JonahZil/fpga-radar-projects/8-point-SDF/README.md

A small proof of concept for a SDF FFT. Includes three stage modules for the 8 point scaled FFT, where each stage module is fully scalable and works for larger FFTs. 

A small testbench is included for the function cos(2pi*n/16), with the console output correctly showing two high output bins while the rest are 0.
