JonahZil/fpga-radar-projects/nonlinearity-tests/python-files/fft-graphs/new/experiment 3/100/3_difference_spectra.png

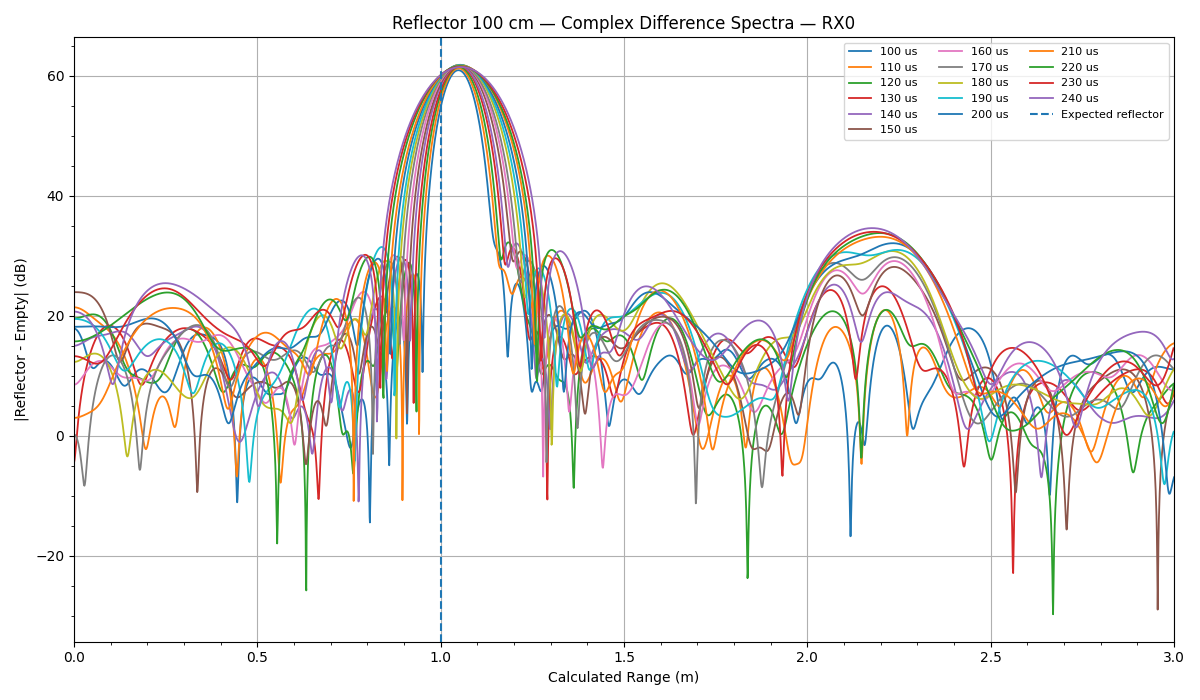
nonlinearity-tests/python-files/fft-graphs/new/experiment 3/100/3_difference_spectra.png
