JonahZil/fpga-radar-projects/nonlinearity-tests/python-files/fft-graphs/new/complex-average/complex-averaging-50.png

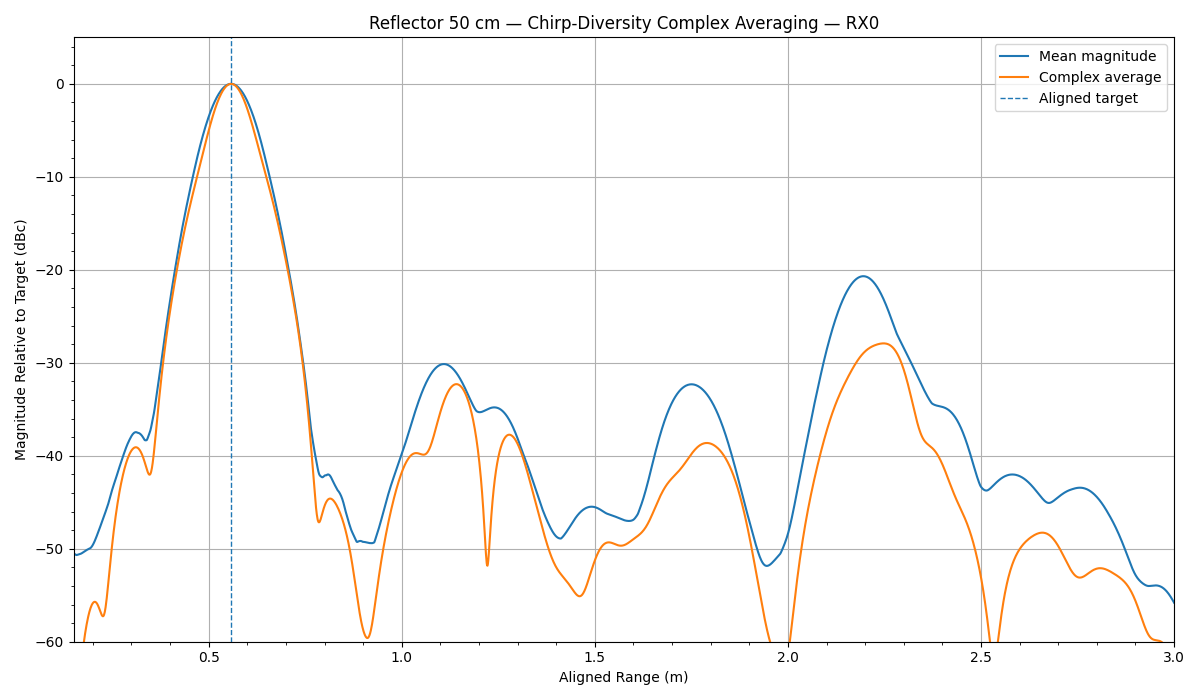
nonlinearity-tests/python-files/fft-graphs/new/complex-average/complex-averaging-50.png
