JonahZil/fpga-radar-projects/nonlinearity-tests/python-files/fft-graphs/new/complex-average/complex_averaging_phase_50.png

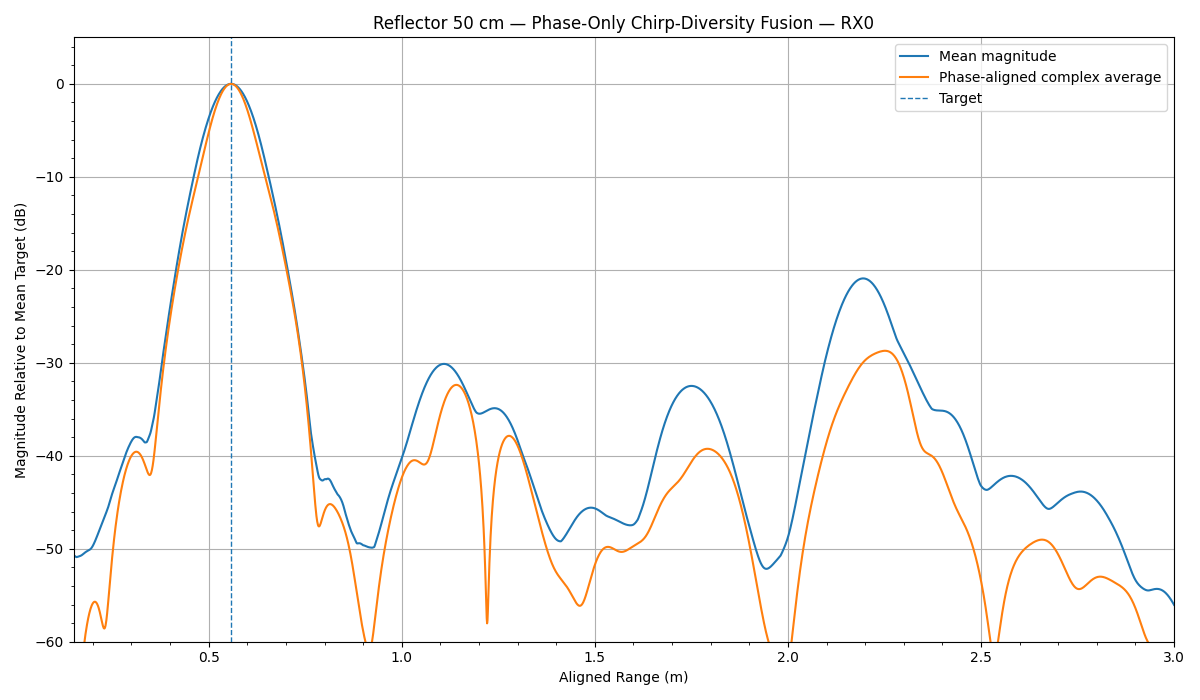
nonlinearity-tests/python-files/fft-graphs/new/complex-average/complex_averaging_phase_50.png
