JonahZil/fpga-radar-projects/nonlinearity-tests/python-files/fft-graphs/new/complex-average/ground_truth.png

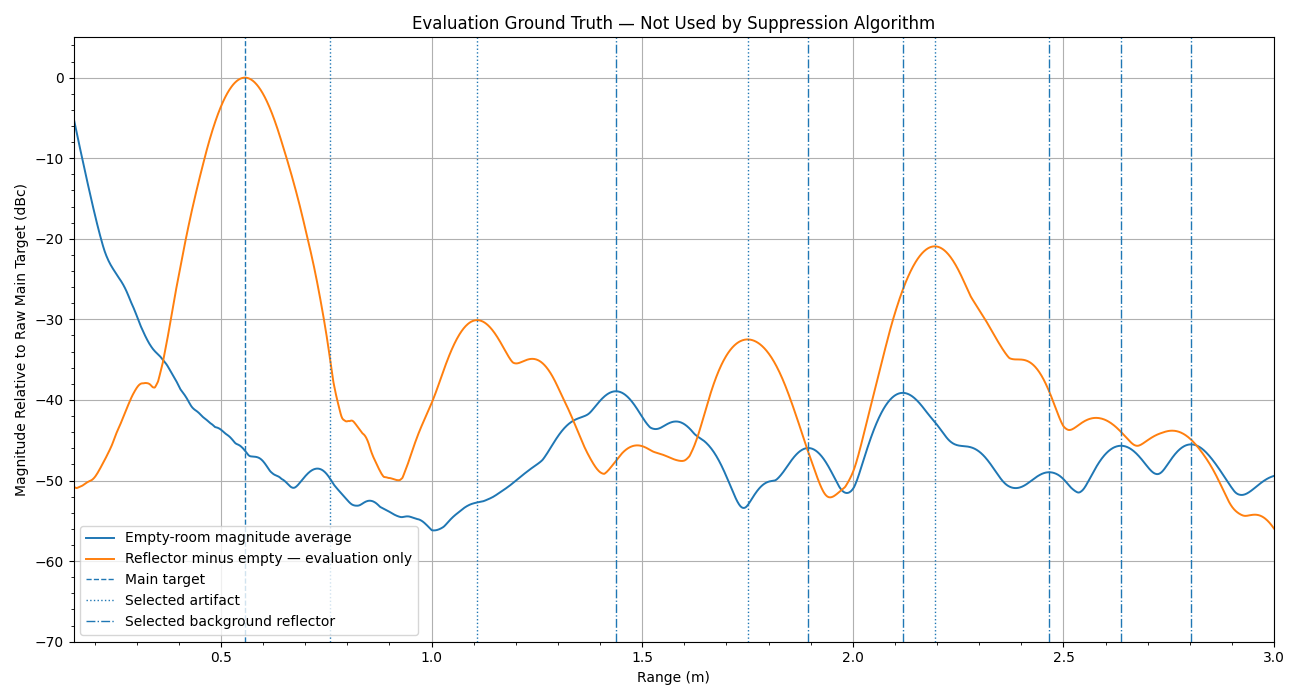
nonlinearity-tests/python-files/fft-graphs/new/complex-average/ground_truth.png
