JonahZil/fpga-radar-projects/nonlinearity-tests/python-files/fft-graphs/new/complex-average/harmonic_phase.png

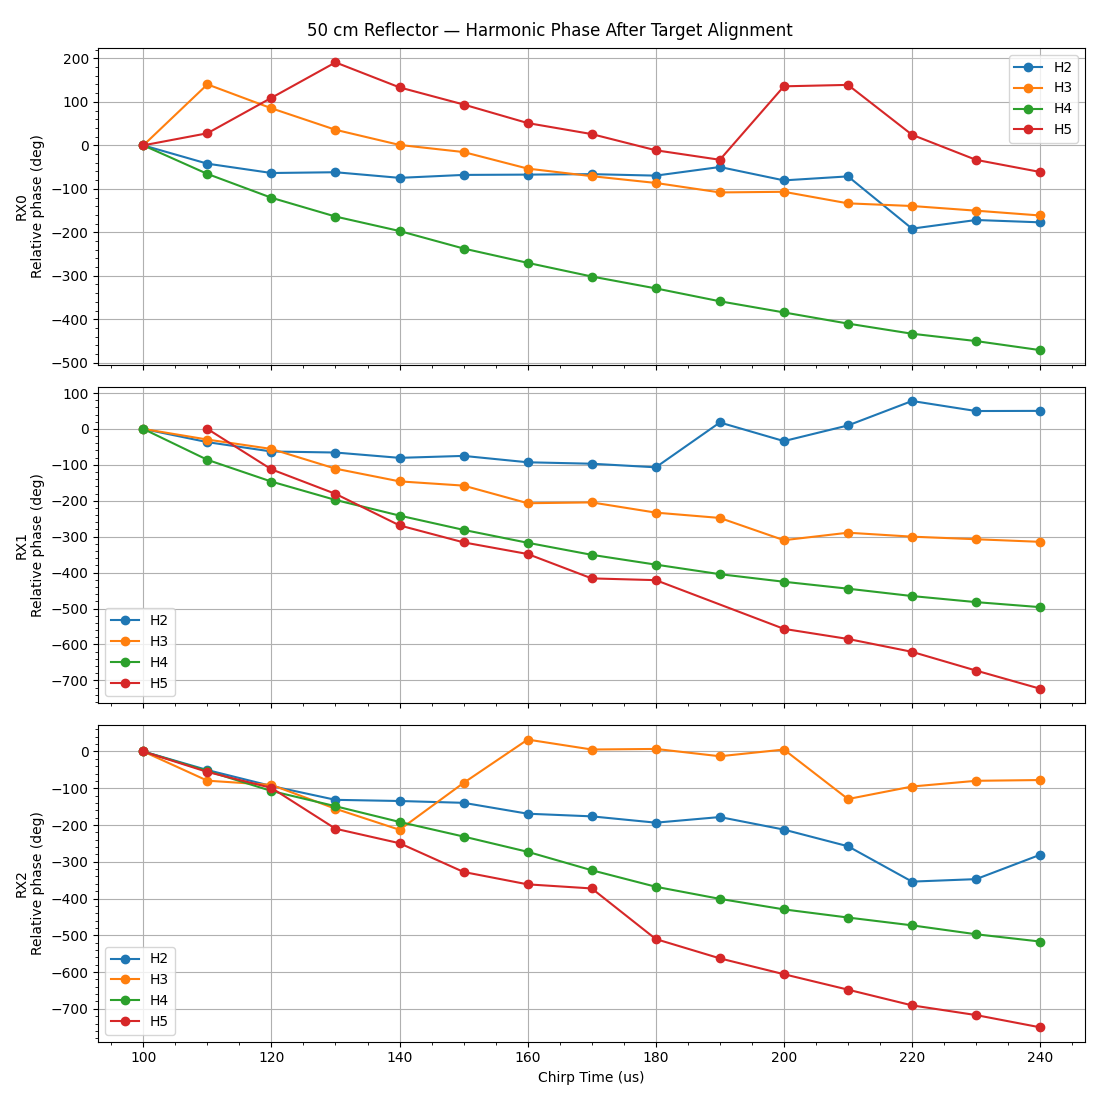
nonlinearity-tests/python-files/fft-graphs/new/complex-average/harmonic_phase.png
