JonahZil/fpga-radar-projects/nonlinearity-tests/python-files/fft-graphs/new/complex-average/linear_fits.png

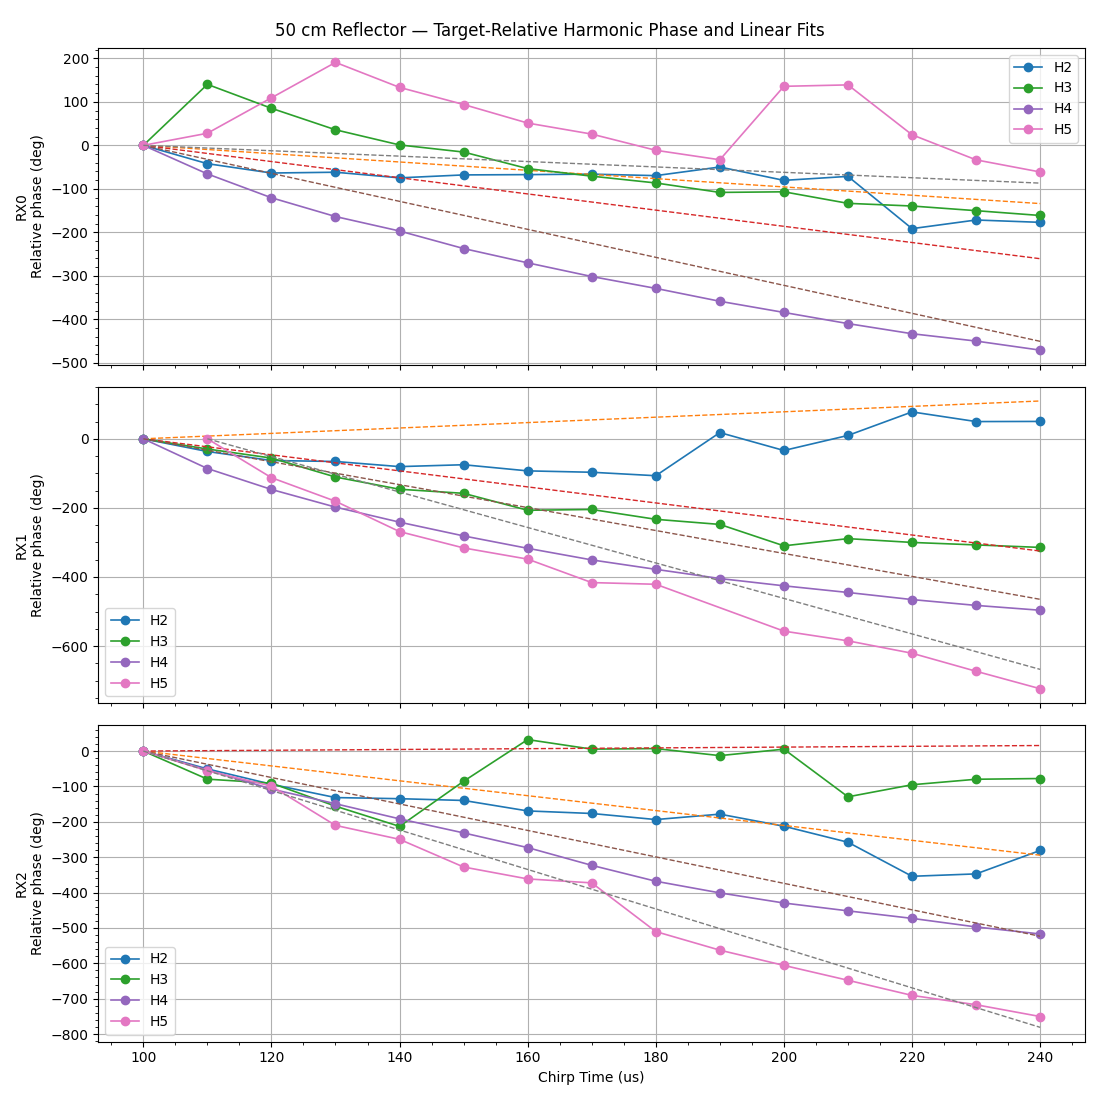
nonlinearity-tests/python-files/fft-graphs/new/complex-average/linear_fits.png
