JonahZil/fpga-radar-projects/nonlinearity-tests/python-files/fft-graphs/new/complex-average/no_background_fusion.png

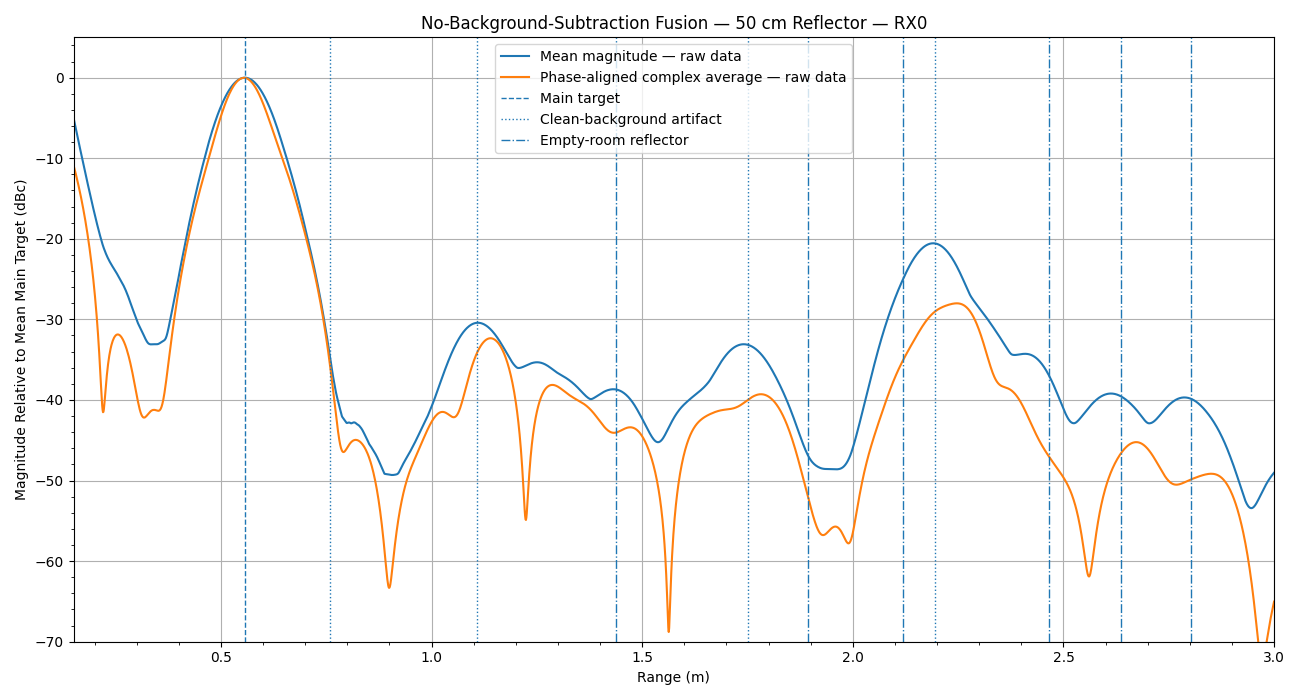
nonlinearity-tests/python-files/fft-graphs/new/complex-average/no_background_fusion.png
