JonahZil/fpga-radar-projects/nonlinearity-tests/python-files/fft-graphs/new/complex-average/phase_offset.png

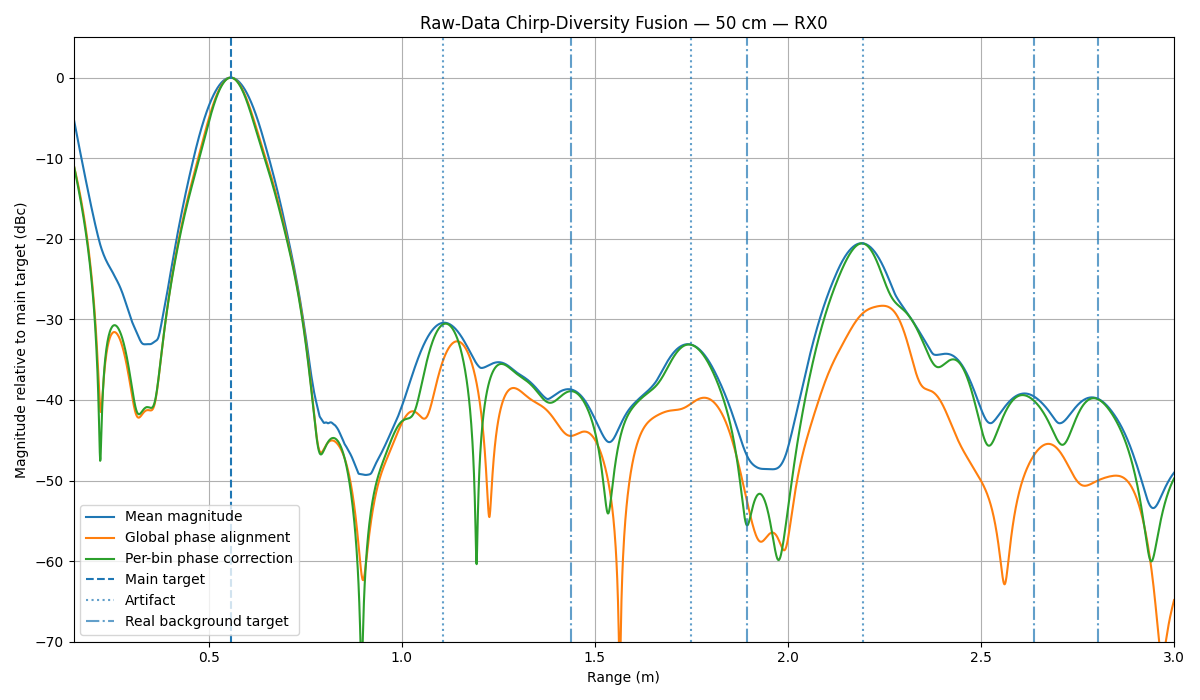
nonlinearity-tests/python-files/fft-graphs/new/complex-average/phase_offset.png
