JonahZil/fpga-radar-projects/nonlinearity-tests/python-files/fft-graphs/new/complex-average/suppression_vs_chirpdiv.png

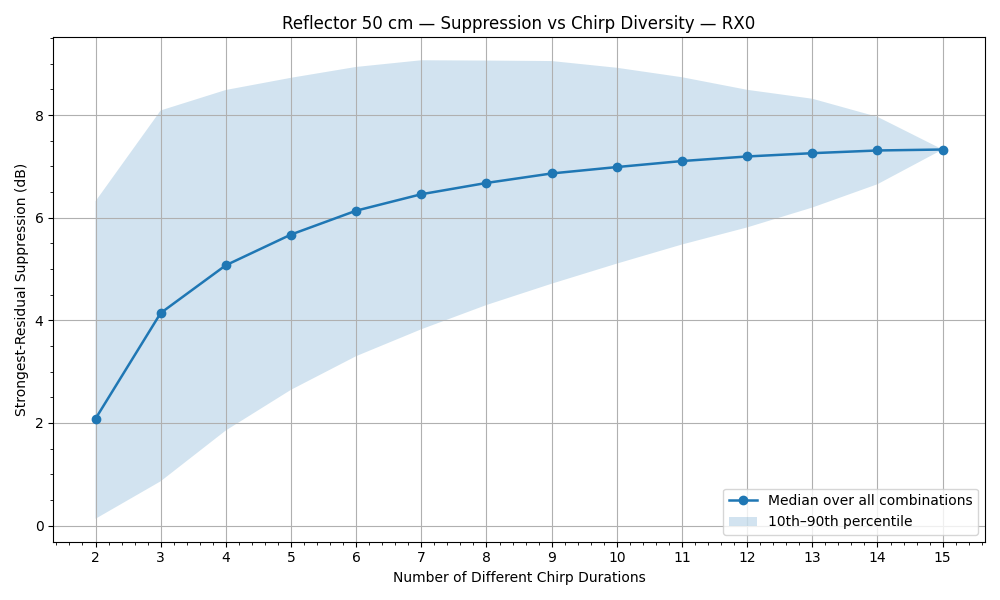
nonlinearity-tests/python-files/fft-graphs/new/complex-average/suppression_vs_chirpdiv.png
