JonahZil/fpga-radar-projects/nonlinearity-tests/python-files/fft-graphs/new/complex-average/supression_at_range.png

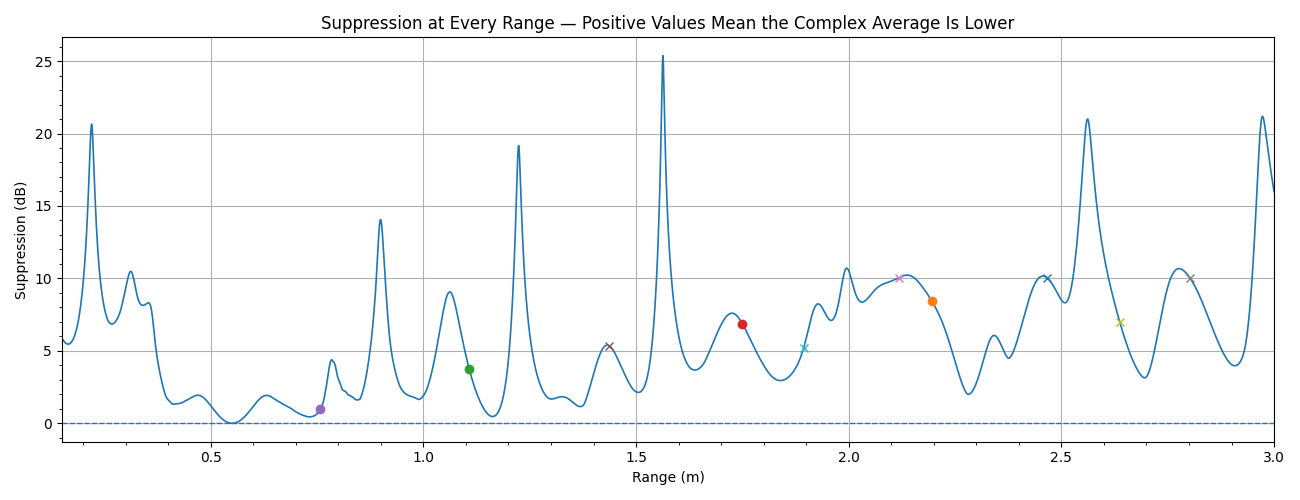
nonlinearity-tests/python-files/fft-graphs/new/complex-average/supression_at_range.png
