JonahZil/fpga-radar-projects/nonlinearity-tests/python-files/fft-graphs/new/experiment 1/1_15_mean.png

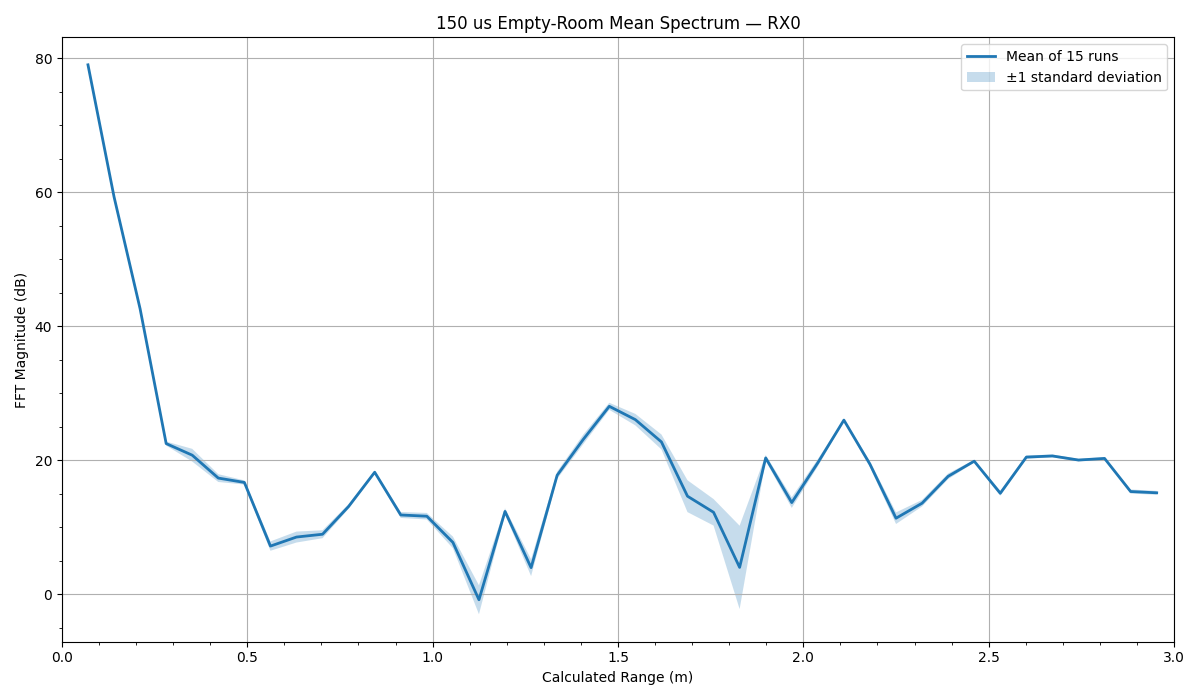
nonlinearity-tests/python-files/fft-graphs/new/experiment 1/1_15_mean.png
