JonahZil/fpga-radar-projects/nonlinearity-tests/python-files/fft-graphs/new/experiment 1/1_15_overlay.png

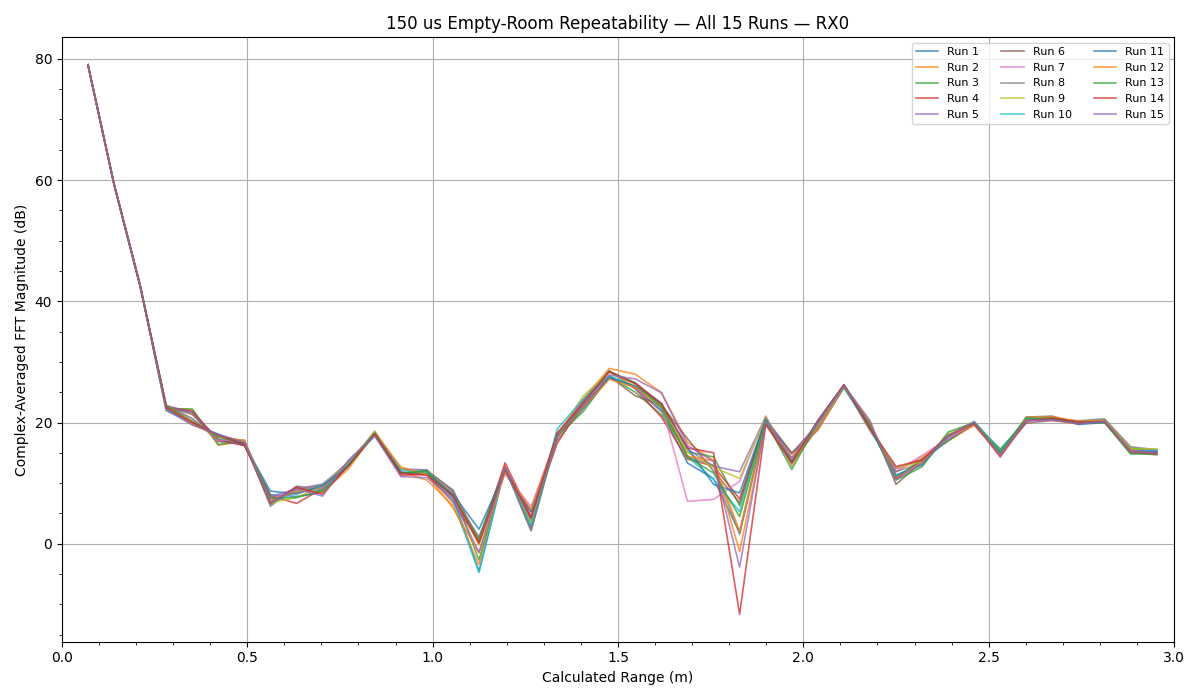
nonlinearity-tests/python-files/fft-graphs/new/experiment 1/1_15_overlay.png
