JonahZil/fpga-radar-projects/nonlinearity-tests/python-files/fft-graphs/new/experiment 2/2_diff_heat.png

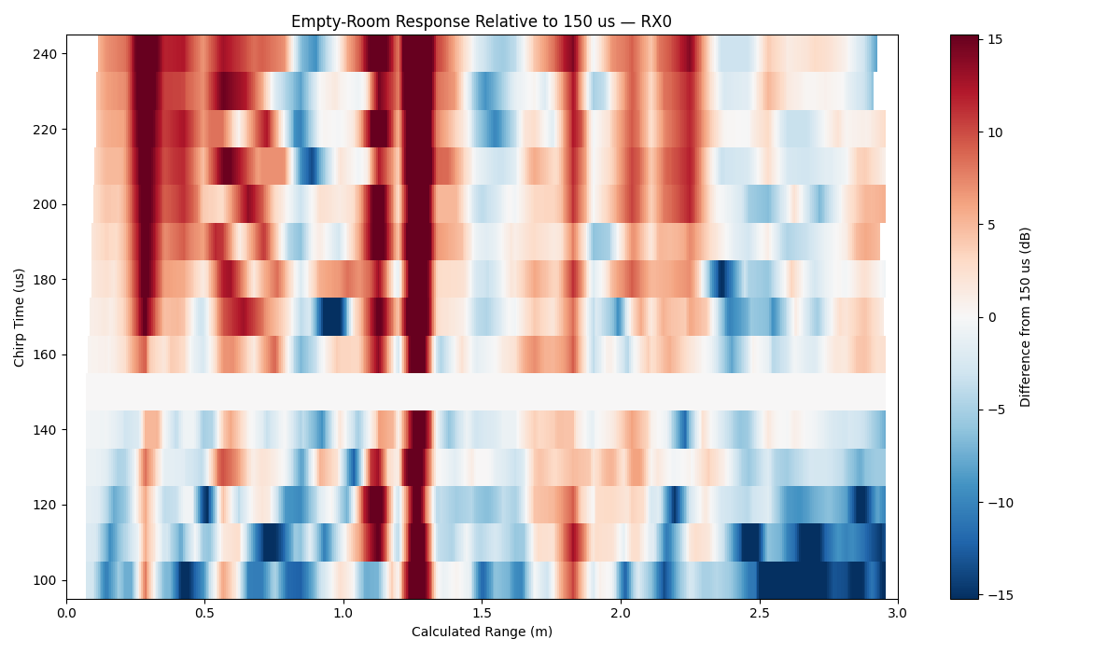
nonlinearity-tests/python-files/fft-graphs/new/experiment 2/2_diff_heat.png
