JonahZil/fpga-radar-projects/nonlinearity-tests/python-files/fft-graphs/new/experiment 2/2_empty_sweep_range.png

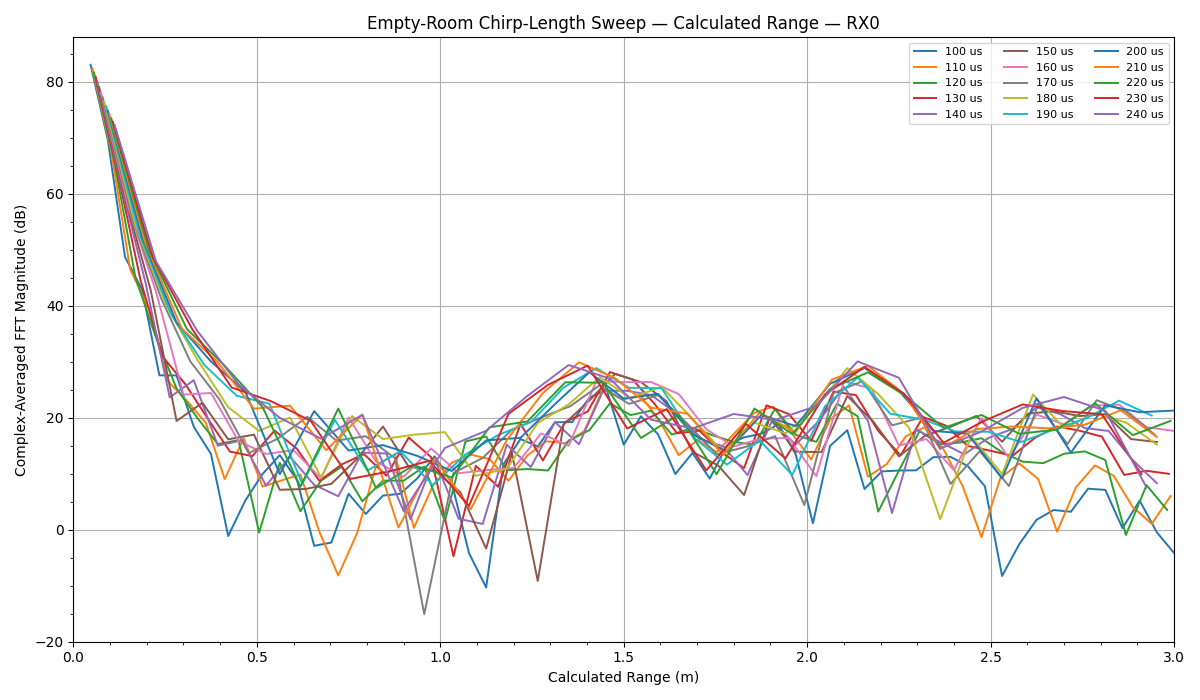
nonlinearity-tests/python-files/fft-graphs/new/experiment 2/2_empty_sweep_range.png
