JonahZil/fpga-radar-projects/nonlinearity-tests/python-files/fft-graphs/new/experiment 2/2exp_beatfreq_vs_time.png

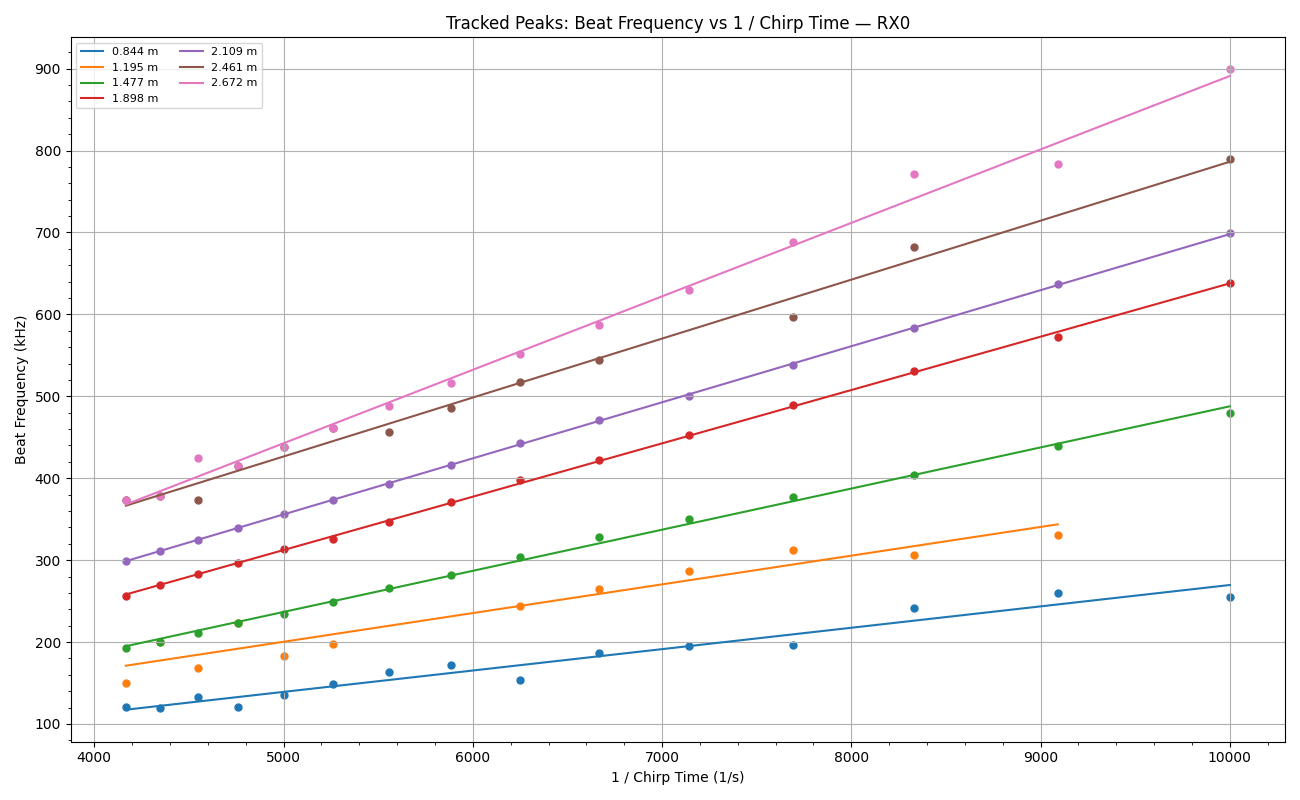
nonlinearity-tests/python-files/fft-graphs/new/experiment 2/2exp_beatfreq_vs_time.png
