JonahZil/fpga-radar-projects/nonlinearity-tests/python-files/fft-graphs/new/experiment 3/50/3_diff_relative_target.png

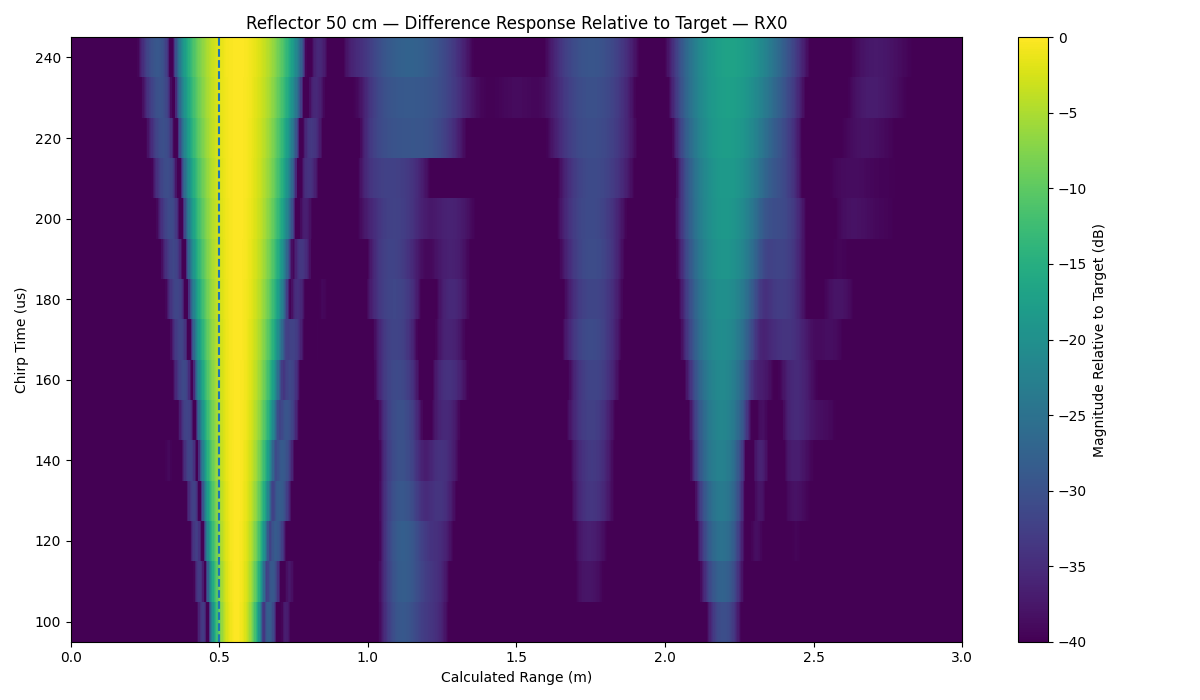
nonlinearity-tests/python-files/fft-graphs/new/experiment 3/50/3_diff_relative_target.png
