JonahZil/fpga-radar-projects/nonlinearity-tests/python-files/fft-graphs/new/experiment 3/50/3_difference_beatfreq_heat.png

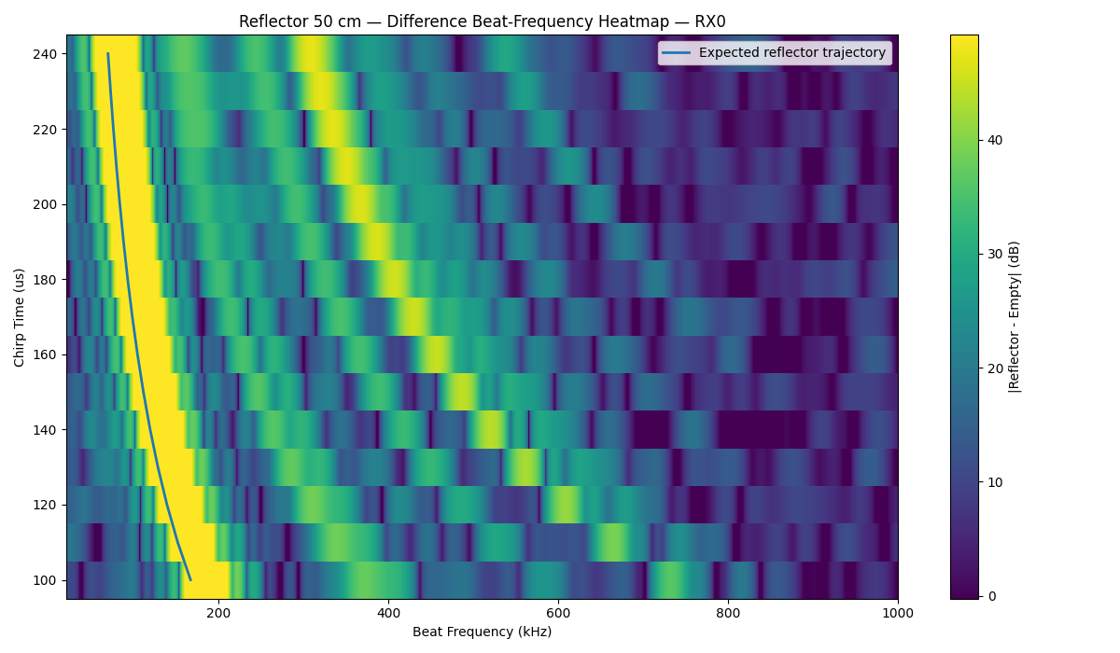
nonlinearity-tests/python-files/fft-graphs/new/experiment 3/50/3_difference_beatfreq_heat.png
