JonahZil/fpga-radar-projects/nonlinearity-tests/python-files/fft-graphs/new/experiment 3/50/3_difference_peak_mag.png

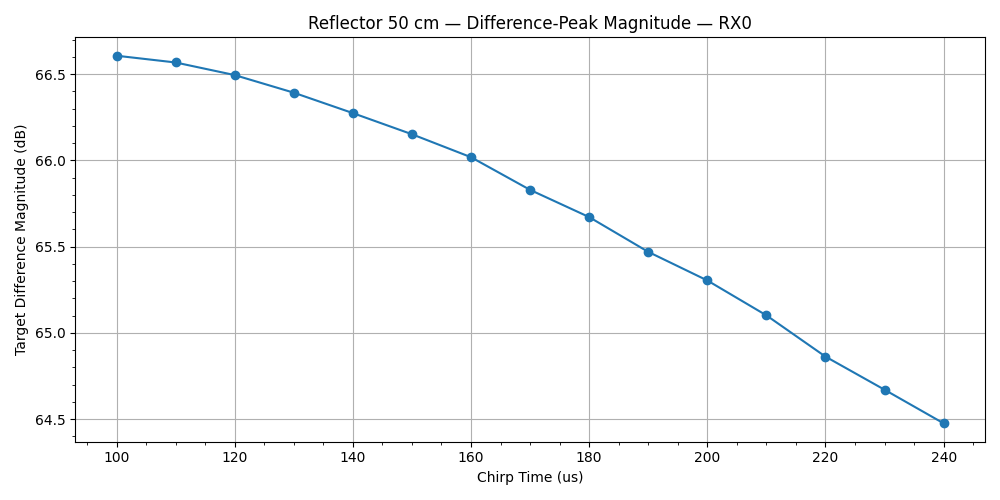
nonlinearity-tests/python-files/fft-graphs/new/experiment 3/50/3_difference_peak_mag.png
