JonahZil/fpga-radar-projects/nonlinearity-tests/python-files/fft-graphs/new/experiment 3/100/3_diff_relative_target.png

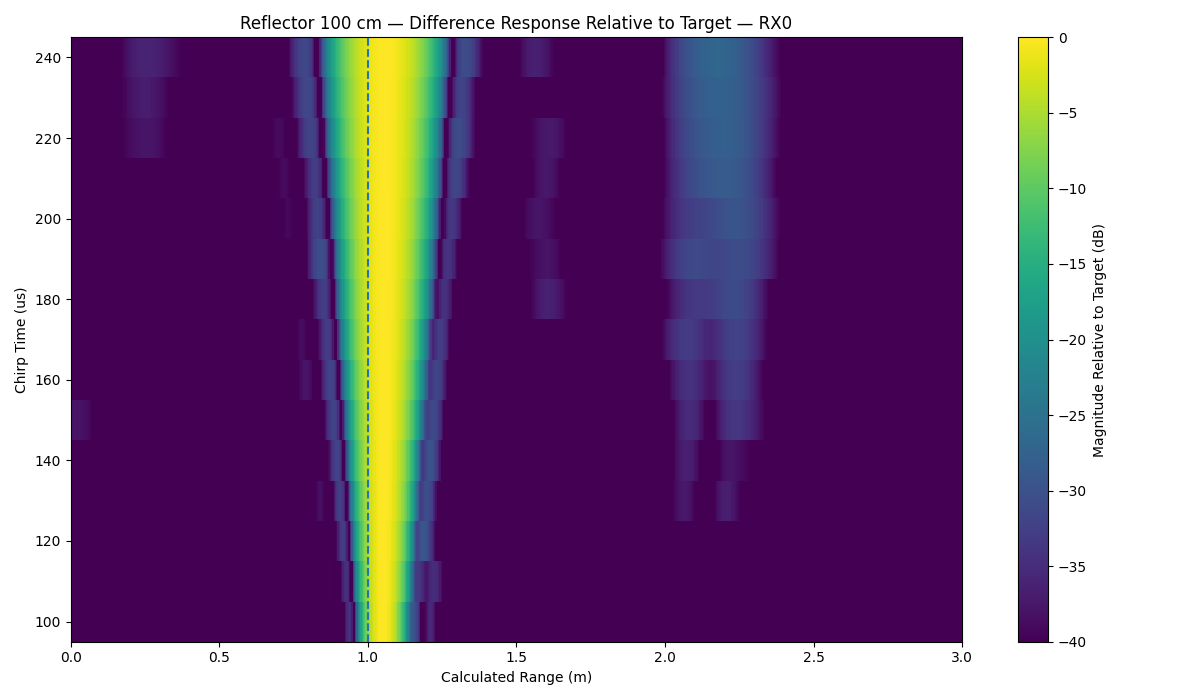
nonlinearity-tests/python-files/fft-graphs/new/experiment 3/100/3_diff_relative_target.png
