JonahZil/fpga-radar-projects/nonlinearity-tests/python-files/fft-graphs/new/experiment 3/150/3_difference_beatfreq_heat.png

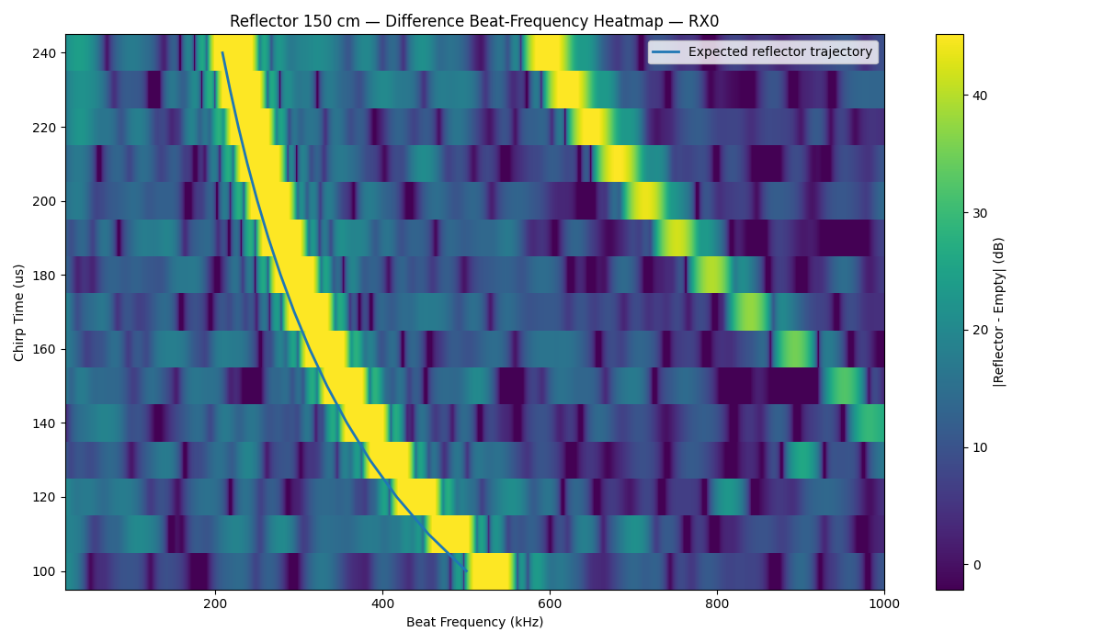
nonlinearity-tests/python-files/fft-graphs/new/experiment 3/150/3_difference_beatfreq_heat.png
