JonahZil/fpga-radar-projects/nonlinearity-tests/python-files/fft-graphs/new/experiment 3/tracked_difference_peak.png

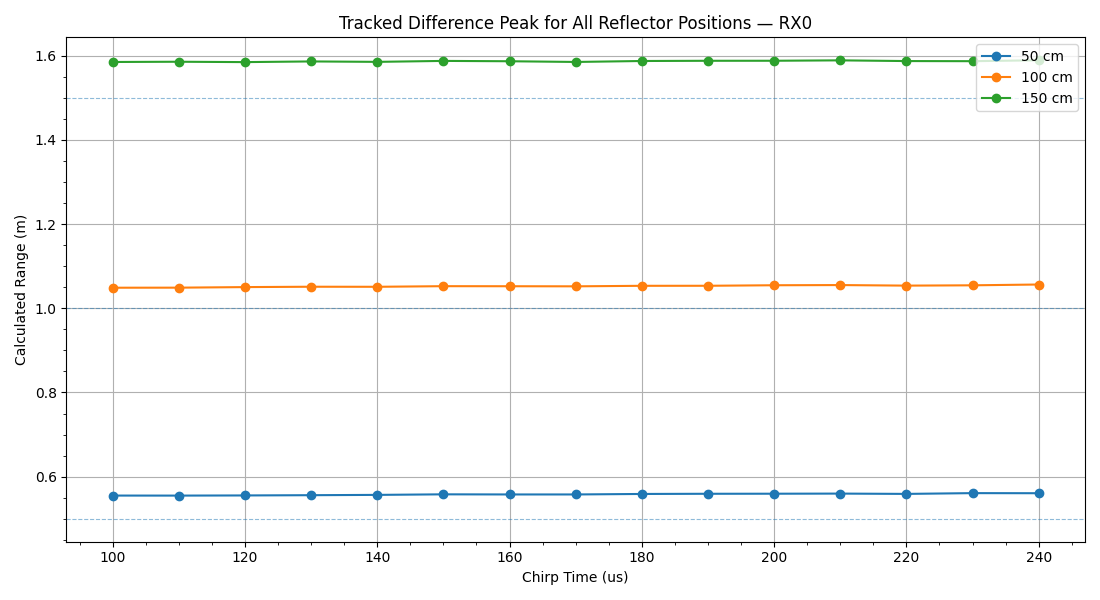
nonlinearity-tests/python-files/fft-graphs/new/experiment 3/tracked_difference_peak.png
