JonahZil/fpga-radar-projects/nonlinearity-tests/python-files/fft-graphs/new/multiple_freq/50_harmonic_freq.png

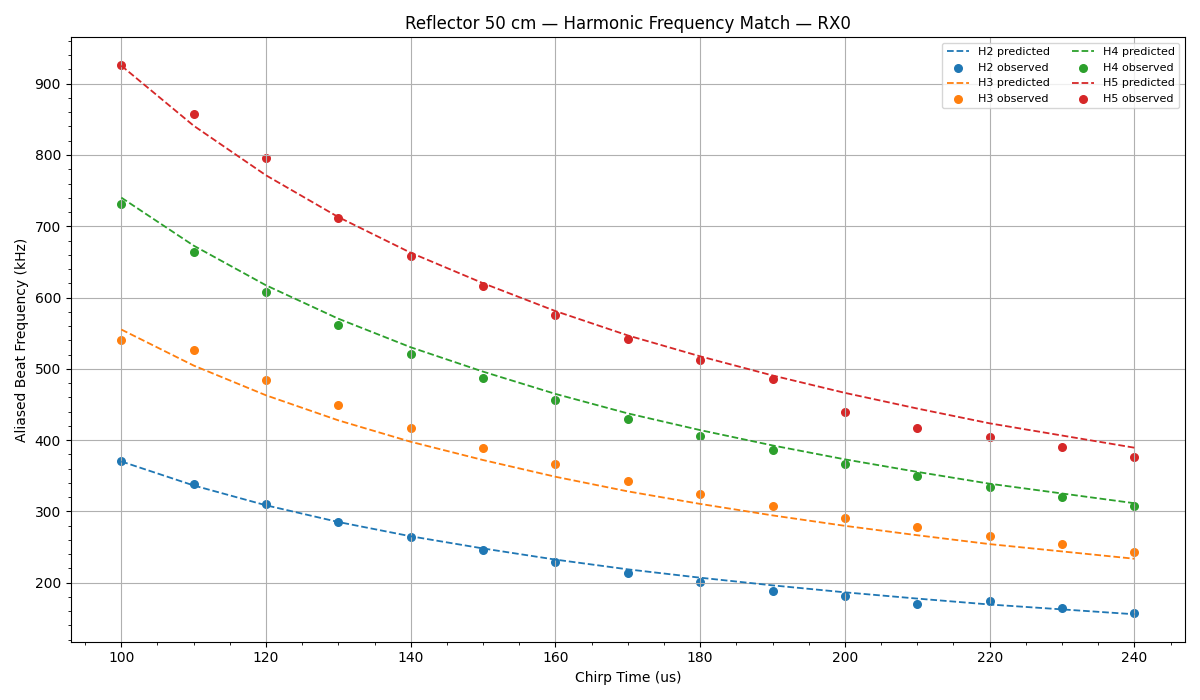
nonlinearity-tests/python-files/fft-graphs/new/multiple_freq/50_harmonic_freq.png
