JonahZil/fpga-radar-projects/nonlinearity-tests/python-files/fft-graphs/new/multiple_freq/150_harmonic_freq.png

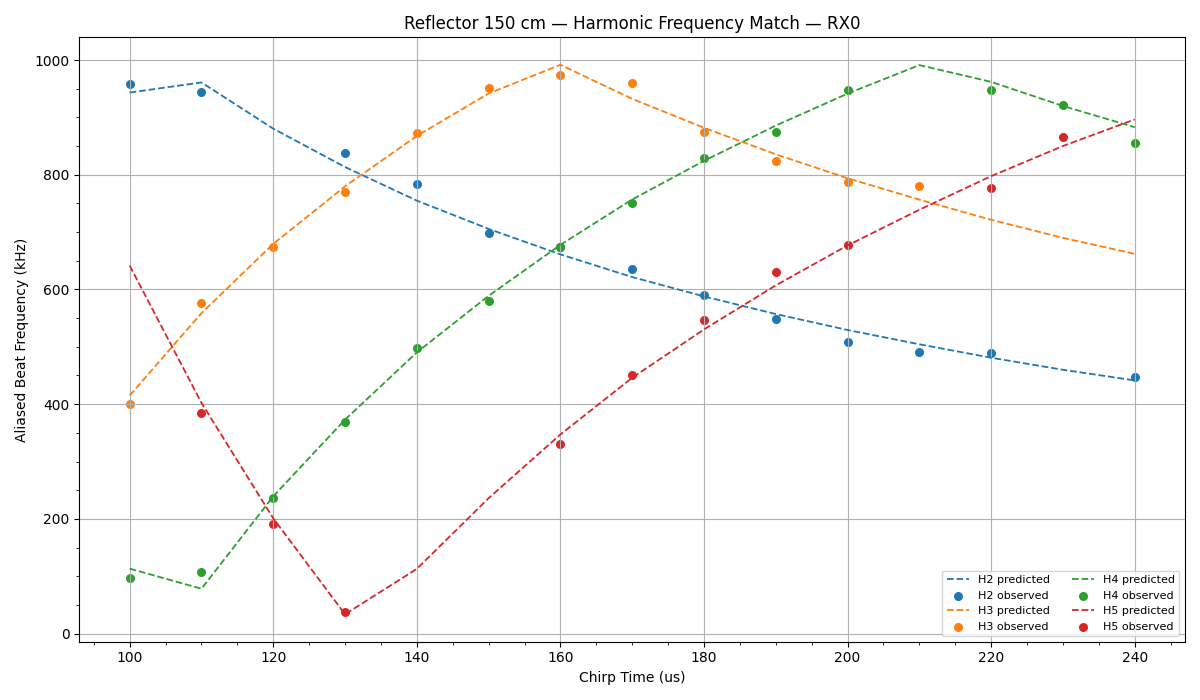
nonlinearity-tests/python-files/fft-graphs/new/multiple_freq/150_harmonic_freq.png
