JonahZil/fpga-radar-projects/nonlinearity-tests/python-files/fft-graphs/new/range-phase/chirp_phase_coherence_0_50.png

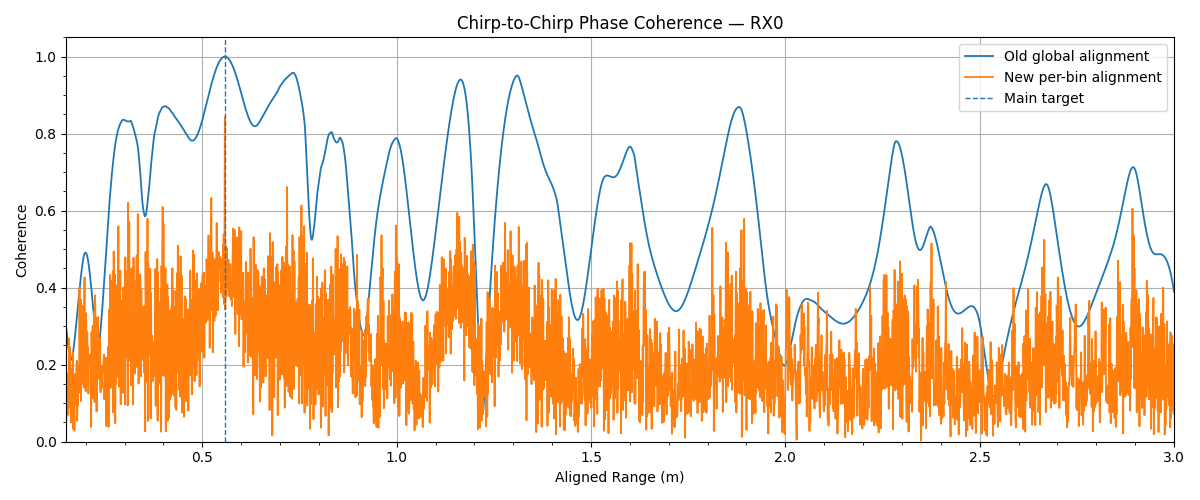
nonlinearity-tests/python-files/fft-graphs/new/range-phase/chirp_phase_coherence_0_50.png
