JonahZil/fpga-radar-projects/nonlinearity-tests/python-files/fft-graphs/new/range-phase/global_vs_per-bin_phase_0_50.png

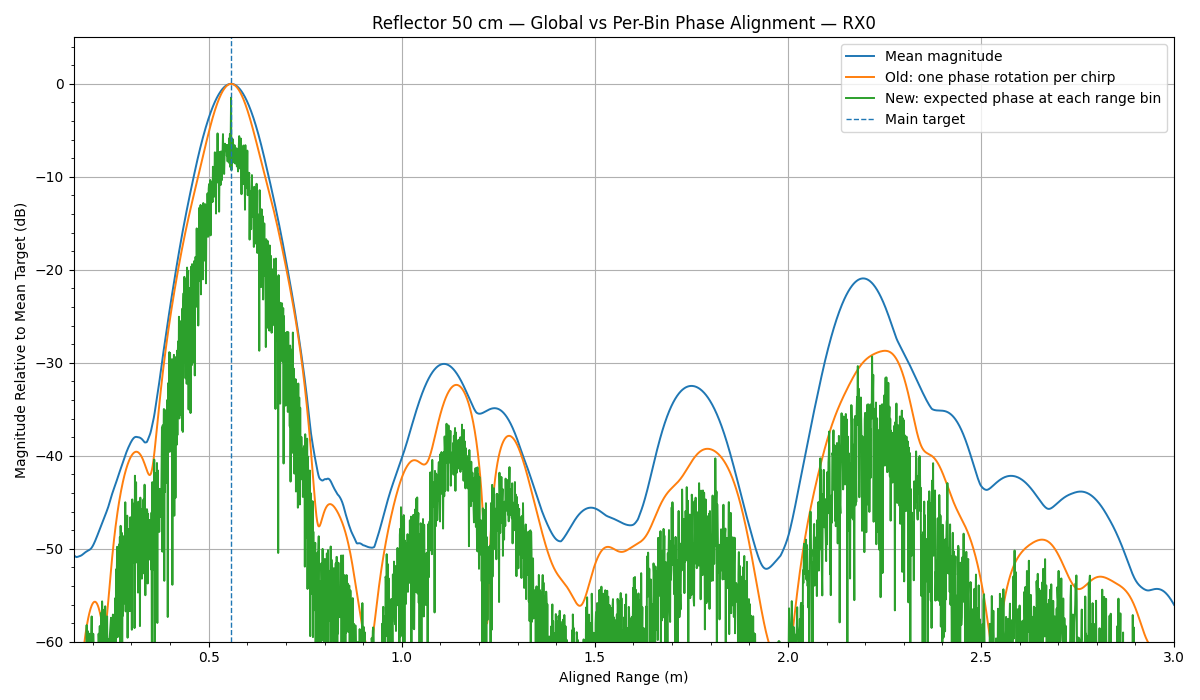
nonlinearity-tests/python-files/fft-graphs/new/range-phase/global_vs_per-bin_phase_0_50.png
