JonahZil/fpga-radar-projects/nonlinearity-tests/python-files/fft-graphs/new/two-reflector/harmonics-50.png

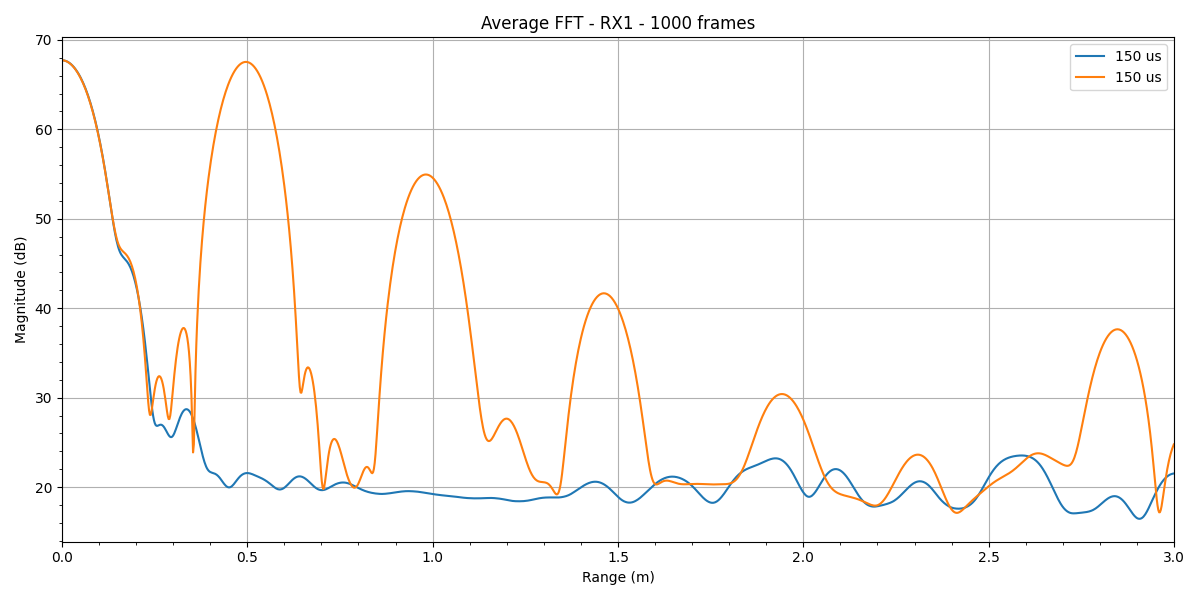
nonlinearity-tests/python-files/fft-graphs/new/two-reflector/harmonics-50.png
