JonahZil/fpga-radar-projects/nonlinearity-tests/python-files/fft-graphs/new/two-reflector/t100_120us.png

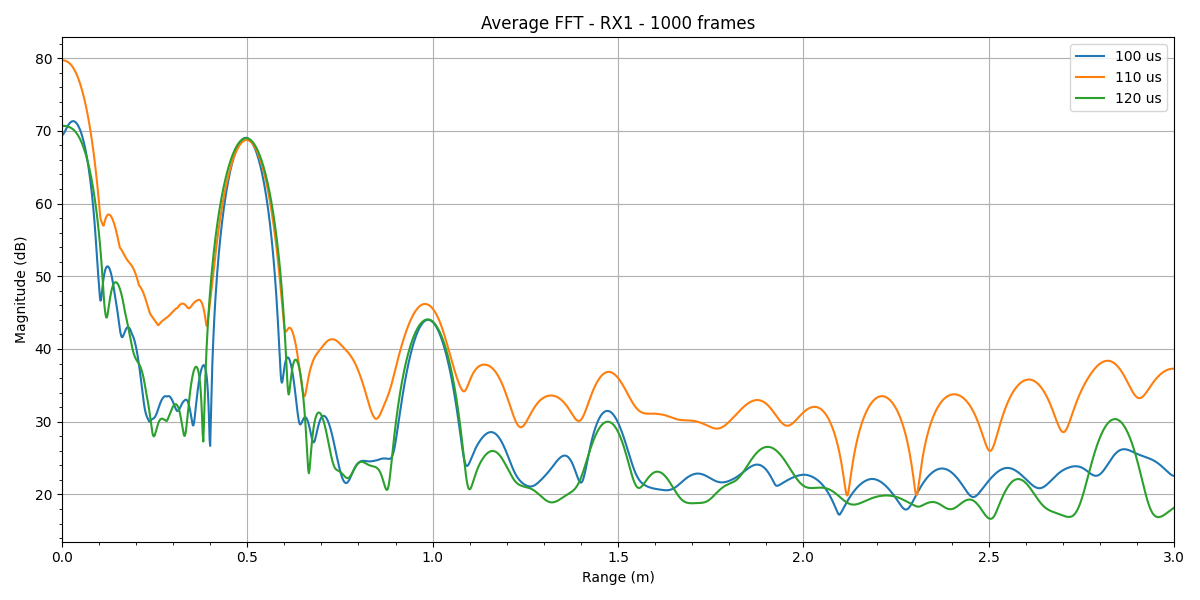
nonlinearity-tests/python-files/fft-graphs/new/two-reflector/t100_120us.png
