JonahZil/fpga-radar-projects/nonlinearity-tests/python-files/fft-graphs/new/two-reflector/t100_160us.png

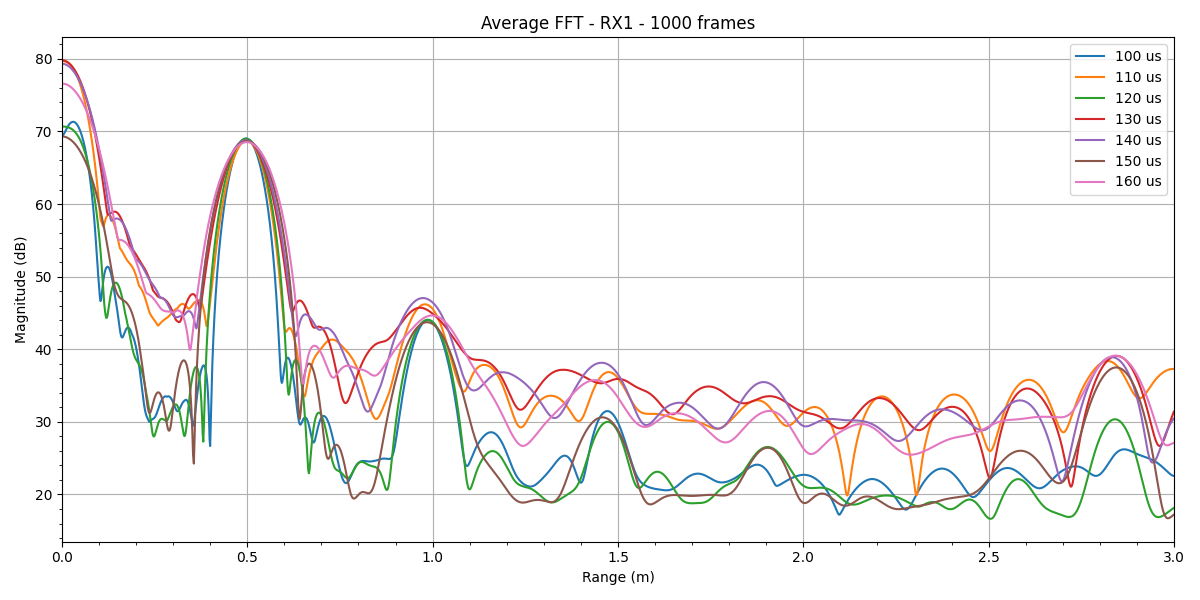
nonlinearity-tests/python-files/fft-graphs/new/two-reflector/t100_160us.png
