JonahZil/fpga-radar-projects/BGT-FMCW-pipeline/adapter-pcb/Adapter-PCB.kicad_pcb

## KiCad design BGT-FMCW-pipeline/adapter-pcb/Adapter-PCB.kicad_pcb (2026-06-25)

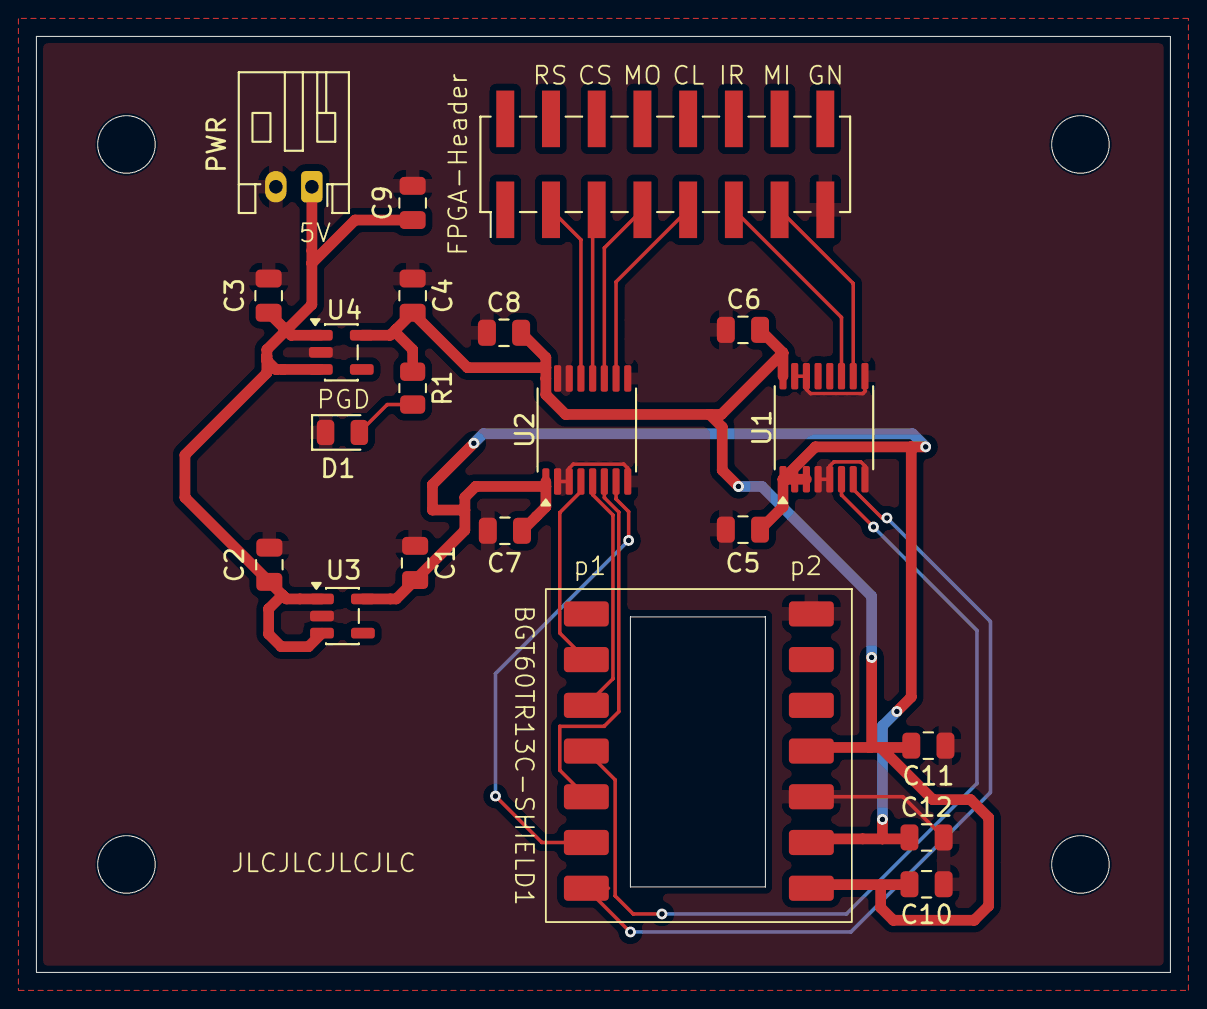
[picture p49: board Adapter-PCB.kicad_pcb from above]

Board: 2 copper layers, 63.0 x 52.0 mm, 21 parts (0 on the bottom side), 17 nets.

Parts:
BGT60TR13C-SHIELD1: BGT60TR13C-SHIELD
C1, C2, C3, C4, C11: 10 µF; C_0805_2012Metric
C5, C6, C7, C8, C10, C12: 100 nF; C_0805_2012Metric
C9: 22 µF; C_0805_2012Metric
D1: LED; LED_0805_2012Metric
FPGA-Header: Conn_02x08_Odd_Even; PinHeader_2x08_P2.54mm_Vertical_SMD
PWR: 5V; JST_PH_S2B-PH-K_1x02_P2.00mm_Horizontal
R1: 1k; R_0805_2012Metric
U1, U2: SN74AVC4T245PW; TSSOP-16_4.4x5mm_P0.65mm
U3: AP2112K-1.8; SOT-23-5
U4: AP2112K-3.3; SOT-23-5

Connections:
+5V: C2.2, C3.2, C9.1, PWR.1, U3.1 (VIN), U3.3 (EN), U4.1 (VIN), U4.3 (EN)
GND: BGT60TR13C-SHIELD1.8 (GND), BGT60TR13C-SHIELD1.12 (GND), C1.1, C2.1, C3.1, C4.1, C5.1, C6.1, C7.1, C8.1, C9.2, C10.1, C11.1, C12.2, D1.1 (K), FPGA-Header.15, PWR.2, U1.4 (1A1), U1.5 (1A2), U1.8 (GND), U1.9 (GND), U1.14 (2~OE), U1.15 (1~OE), U2.2 (1DIR), U2.3 (2DIR), U2.8 (GND), U2.9 (GND), U2.14 (2~OE), U2.15 (1~OE), U3.2 (GND), U4.2 (GND)
unnamed: BGT60TR13C-SHIELD1.13 (1V8S), C1.2, C5.2, C7.2, C12.1, U1.1 (VCCA), U1.2 (1DIR), U1.3 (2DIR), U2.1 (VCCA), U3.5 (VOUT)
unnamed: BGT60TR13C-SHIELD1.11 (3V3D), BGT60TR13C-SHIELD1.14 (3V3S), C4.2, C6.2, C8.2, C10.2, C11.2, R1.1, U1.16 (VCCB), U2.16 (VCCB), U4.5 (VOUT)
unnamed: BGT60TR13C-SHIELD1.7 (IRQ), U1.7 (2A2)
unnamed: BGT60TR13C-SHIELD1.2 (RST), U2.4 (1A1)
unnamed: BGT60TR13C-SHIELD1.6 (SPI_CLK), U2.7 (2A2)
unnamed: BGT60TR13C-SHIELD1.3 (SPI_CSN), U2.5 (1A2)
unnamed: BGT60TR13C-SHIELD1.4 (SPI_MISO), U1.6 (2A1)
unnamed: BGT60TR13C-SHIELD1.5 (SPI_MOSI), U2.6 (2A1)
unnamed: D1.2 (A), R1.2
unnamed: FPGA-Header.3, U2.13 (1B1)
unnamed: FPGA-Header.5, U2.12 (1B2)
unnamed: FPGA-Header.7, U2.11 (2B1)
unnamed: FPGA-Header.9, U2.10 (2B2)
unnamed: FPGA-Header.11, U1.11 (2B1)
unnamed: FPGA-Header.13, U1.10 (2B2)
