JonahZil/fpga-radar-projects/BGT-FMCW-pipeline/ps-pl-hdl/fmcw-output-slave_slave_lite_v1_0_S00_AXI.v

`timescale 1 ns / 1 ps

module fmcw_output_slave_slave_lite_v1_0_S00_AXI #
(
    parameter integer C_S_AXI_DATA_WIDTH = 32,
    parameter integer C_S_AXI_ADDR_WIDTH = 5
)
(
    // Radar pipeline handshake
    output reg buf_out_ready,

    // Radar pipeline results
    input wire signed [17:0] alpha,
    input wire signed [17:0] beta,
    input wire        [23:0] range_calc,
    input wire               buf_out_valid,

    // Global clock signal
    input wire S_AXI_ACLK,

    // Global reset signal, active low
    input wire S_AXI_ARESETN,

    // Write address channel
    input  wire [C_S_AXI_ADDR_WIDTH-1:0] S_AXI_AWADDR,
    input  wire [2:0]                    S_AXI_AWPROT,
    input  wire                          S_AXI_AWVALID,
    output wire                          S_AXI_AWREADY,

    // Write data channel
    input  wire [C_S_AXI_DATA_WIDTH-1:0]     S_AXI_WDATA,
    input  wire [(C_S_AXI_DATA_WIDTH/8)-1:0] S_AXI_WSTRB,
    input  wire                              S_AXI_WVALID,
    output wire                              S_AXI_WREADY,

    // Write response channel
    output wire [1:0] S_AXI_BRESP,
    output wire       S_AXI_BVALID,
    input  wire       S_AXI_BREADY,

    // Read address channel
    input  wire [C_S_AXI_ADDR_WIDTH-1:0] S_AXI_ARADDR,
    input  wire [2:0]                    S_AXI_ARPROT,
    input  wire                          S_AXI_ARVALID,
    output wire                          S_AXI_ARREADY,

    // Read data channel
    output wire [C_S_AXI_DATA_WIDTH-1:0] S_AXI_RDATA,
    output wire [1:0]                    S_AXI_RRESP,
    output wire                          S_AXI_RVALID,
    input  wire                          S_AXI_RREADY
);

    // AXI4LITE signals
    reg [C_S_AXI_ADDR_WIDTH-1:0] axi_awaddr;
    reg                          axi_awready;
    reg                          axi_wready;
    reg [1:0]                    axi_bresp;
    reg                          axi_bvalid;

    reg [C_S_AXI_ADDR_WIDTH-1:0] axi_araddr;
    reg                          axi_arready;
    reg [1:0]                    axi_rresp;
    reg                          axi_rvalid;

    assign S_AXI_AWREADY = axi_awready;
    assign S_AXI_WREADY  = axi_wready;
    assign S_AXI_BRESP   = axi_bresp;
    assign S_AXI_BVALID  = axi_bvalid;

    assign S_AXI_ARREADY = axi_arready;
    assign S_AXI_RRESP   = axi_rresp;
    assign S_AXI_RVALID  = axi_rvalid;

    localparam integer ADDR_LSB = (C_S_AXI_DATA_WIDTH / 32) + 1;
    localparam integer OPT_MEM_ADDR_BITS = 2;

    wire [C_S_AXI_ADDR_WIDTH-1:0] write_addr_for_decode;
    wire [2:0] write_reg_addr;
    wire [2:0] read_reg_addr;

    assign write_addr_for_decode =
        (S_AXI_AWVALID && axi_awready) ?
        S_AXI_AWADDR :
        axi_awaddr;

    assign write_reg_addr =
        write_addr_for_decode[
            ADDR_LSB + OPT_MEM_ADDR_BITS : ADDR_LSB
        ];

    assign read_reg_addr =
        S_AXI_ARADDR[
            ADDR_LSB + OPT_MEM_ADDR_BITS : ADDR_LSB
        ];

    reg [C_S_AXI_DATA_WIDTH-1:0] slv_reg0; // 0x00: control
    reg [C_S_AXI_DATA_WIDTH-1:0] slv_reg1; // 0x04: status
    reg [C_S_AXI_DATA_WIDTH-1:0] slv_reg2; // 0x08: range
    reg [C_S_AXI_DATA_WIDTH-1:0] slv_reg3; // 0x0C: alpha
    reg [C_S_AXI_DATA_WIDTH-1:0] slv_reg4; // 0x10: beta

    wire slv_reg_wren;
    wire slv_reg_rden;

    assign slv_reg_wren =
        S_AXI_WVALID  &&
        axi_wready    &&
        S_AXI_AWVALID &&
        axi_awready;

    assign slv_reg_rden =
        S_AXI_ARVALID &&
        axi_arready;

    // Write state machine
    reg [1:0] state_write;

    localparam Idle  = 2'b00;
    localparam Waddr = 2'b10;
    localparam Wdata = 2'b11;

    always @(posedge S_AXI_ACLK)
    begin
        if (!S_AXI_ARESETN)
        begin
            axi_awready <= 1'b0;
            axi_wready  <= 1'b0;
            axi_bvalid  <= 1'b0;
            axi_bresp   <= 2'b00;
            axi_awaddr  <= {C_S_AXI_ADDR_WIDTH{1'b0}};
            state_write <= Idle;
        end
        else
        begin
            case (state_write)

                Idle:
                begin
                    axi_awready <= 1'b1;
                    axi_wready  <= 1'b1;
                    state_write <= Waddr;
                end

                Waddr:
                begin
                    if (S_AXI_AWVALID && S_AXI_AWREADY)
                    begin
                        axi_awaddr <= S_AXI_AWADDR;

                        if (S_AXI_WVALID)
                        begin
                            axi_awready <= 1'b1;
                            state_write <= Waddr;
                            axi_bvalid  <= 1'b1;
                            axi_bresp   <= 2'b00;
                        end
                        else
                        begin
                            axi_awready <= 1'b0;
                            state_write <= Wdata;
                        end
                    end

                    if (S_AXI_BREADY && axi_bvalid)
                    begin
                        axi_bvalid <= 1'b0;
                    end
                end

                Wdata:
                begin
                    if (S_AXI_WVALID)
                    begin
                        state_write <= Waddr;
                        axi_bvalid  <= 1'b1;
                        axi_bresp   <= 2'b00;
                        axi_awready <= 1'b1;
                    end

                    if (S_AXI_BREADY && axi_bvalid)
                    begin
                        axi_bvalid <= 1'b0;
                    end
                end

                default:
                begin
                    state_write <= Idle;
                end

            endcase
        end
    end

    integer byte_index;

    always @(posedge S_AXI_ACLK)
    begin
        if (!S_AXI_ARESETN)
        begin
            slv_reg0 <= {C_S_AXI_DATA_WIDTH{1'b0}};
            slv_reg1 <= {C_S_AXI_DATA_WIDTH{1'b0}};
            slv_reg2 <= {C_S_AXI_DATA_WIDTH{1'b0}};
            slv_reg3 <= {C_S_AXI_DATA_WIDTH{1'b0}};
            slv_reg4 <= {C_S_AXI_DATA_WIDTH{1'b0}};

            buf_out_ready <= 1'b0;
        end
        else
        begin
            // Default state
            buf_out_ready <= 1'b0;

            // bit 1 = output available
            slv_reg1 <= {
                {(C_S_AXI_DATA_WIDTH-2){1'b0}},
                buf_out_valid,
                1'b0
            };

            if (buf_out_valid)
            begin
                // 0x08: unsigned 24-bit range
                slv_reg2 <= {
                    {(C_S_AXI_DATA_WIDTH-24){1'b0}},
                    range_calc
                };

                // 0x0C: signed 18-bit alpha angle
                slv_reg3 <= {
                    {(C_S_AXI_DATA_WIDTH-18){alpha[17]}},
                    alpha
                };

                // 0x10: signed 18-bit beta angle
                slv_reg4 <= {
                    {(C_S_AXI_DATA_WIDTH-18){beta[17]}},
                    beta
                };
            end

            if (slv_reg_wren)
            begin
                case (write_reg_addr)

                    // 0x00: control
                    3'h0:
                    begin
                        for (
                            byte_index = 0;
                            byte_index < C_S_AXI_DATA_WIDTH / 8;
                            byte_index = byte_index + 1
                        )
                        begin
                            if (S_AXI_WSTRB[byte_index])
                            begin
                                slv_reg0[
                                    (byte_index * 8) +: 8
                                ] <= S_AXI_WDATA[
                                    (byte_index * 8) +: 8
                                ];
                            end
                        end
                    end

                    default:
                    begin
                    end

                endcase
            end
            
            //If the last register is read, the PS is ready
            if (slv_reg_rden)
            begin
                case (read_reg_addr)
                    3'h4:
                    begin
                        buf_out_ready <= buf_out_valid;
                    end

                    default:
                    begin
                    end

                endcase
            end
        end
    end

    // AXI read state machine
    reg [1:0] state_read;

    localparam Raddr = 2'b10;
    localparam Rdata = 2'b11;

    always @(posedge S_AXI_ACLK)
    begin
        if (!S_AXI_ARESETN)
        begin
            axi_arready <= 1'b0;
            axi_rvalid  <= 1'b0;
            axi_rresp   <= 2'b00;
            axi_araddr  <= {C_S_AXI_ADDR_WIDTH{1'b0}};
            state_read  <= Idle;
        end
        else
        begin
            case (state_read)

                Idle:
                begin
                    state_read  <= Raddr;
                    axi_arready <= 1'b1;
                end

                Raddr:
                begin
                    if (S_AXI_ARVALID && S_AXI_ARREADY)
                    begin
                        axi_araddr  <= S_AXI_ARADDR;
                        axi_arready <= 1'b0;
                        axi_rvalid  <= 1'b1;
                        axi_rresp   <= 2'b00;
                        state_read  <= Rdata;
                    end
                end

                Rdata:
                begin
                    if (S_AXI_RVALID && S_AXI_RREADY)
                    begin
                        axi_rvalid  <= 1'b0;
                        axi_arready <= 1'b1;
                        state_read  <= Raddr;
                    end
                end

                default:
                begin
                    state_read <= Idle;
                end

            endcase
        end
    end

    assign S_AXI_RDATA =
        (
            axi_araddr[
                ADDR_LSB + OPT_MEM_ADDR_BITS : ADDR_LSB
            ] == 3'h0
        ) ? slv_reg0 :

        (
            axi_araddr[
                ADDR_LSB + OPT_MEM_ADDR_BITS : ADDR_LSB
            ] == 3'h1
        ) ? slv_reg1 :

        (
            axi_araddr[
                ADDR_LSB + OPT_MEM_ADDR_BITS : ADDR_LSB
            ] == 3'h2
        ) ? slv_reg2 :

        (
            axi_araddr[
                ADDR_LSB + OPT_MEM_ADDR_BITS : ADDR_LSB
            ] == 3'h3
        ) ? slv_reg3 :

        (
            axi_araddr[
                ADDR_LSB + OPT_MEM_ADDR_BITS : ADDR_LSB
            ] == 3'h4
        ) ? slv_reg4 :

        {C_S_AXI_DATA_WIDTH{1'b0}};

endmodule
