JonahZil/fpga-radar-projects/32-point-SDF-FFT-pipeline/block design/block_design_fft_32_point_0_0.v

// (c) Copyright 1986-2022 Xilinx, Inc. All Rights Reserved.
// (c) Copyright 2022-2026 Advanced Micro Devices, Inc. All rights reserved.
// 
// This file contains confidential and proprietary information
// of AMD and is protected under U.S. and international copyright
// and other intellectual property laws.
// 
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
// CRITICAL APPLICATIONS
// AMD products are not designed or intended to be fail-
// safe, or for use in any application requiring fail-safe
// performance, such as life-support or safety devices or
// systems, Class III medical devices, nuclear facilities,
// applications related to the deployment of airbags, or any
// other applications that could lead to death, personal
// injury, or severe property or environmental damage
// (individually and collectively, "Critical
// Applications"). Customer assumes the sole risk and
// liability of any use of AMD products in Critical
// Applications, subject only to applicable laws and
// regulations governing limitations on product liability.
// 
// THIS COPYRIGHT NOTICE AND DISCLAIMER MUST BE RETAINED AS
// PART OF THIS FILE AT ALL TIMES.
// 
// DO NOT MODIFY THIS FILE.


// IP VLNV: xilinx.com:user:fft_32_point:1.0
// IP Revision: 1

(* X_CORE_INFO = "fft_ip,Vivado 2025.2" *)
(* CHECK_LICENSE_TYPE = "block_design_fft_32_point_0_0,fft_ip,{}" *)
(* CORE_GENERATION_INFO = "block_design_fft_32_point_0_0,fft_ip,{x_ipProduct=Vivado 2025.2,x_ipVendor=xilinx.com,x_ipLibrary=user,x_ipName=fft_32_point,x_ipVersion=1.0,x_ipCoreRevision=1,x_ipLanguage=VERILOG,x_ipSimLanguage=MIXED,C_S00_AXI_DATA_WIDTH=32,C_S00_AXI_ADDR_WIDTH=4}" *)
(* DowngradeIPIdentifiedWarnings = "yes" *)
module block_design_fft_32_point_0_0 (
  s00_axi_awaddr,
  s00_axi_awprot,
  s00_axi_awvalid,
  s00_axi_awready,
  s00_axi_wdata,
  s00_axi_wstrb,
  s00_axi_wvalid,
  s00_axi_wready,
  s00_axi_bresp,
  s00_axi_bvalid,
  s00_axi_bready,
  s00_axi_araddr,
  s00_axi_arprot,
  s00_axi_arvalid,
  s00_axi_arready,
  s00_axi_rdata,
  s00_axi_rresp,
  s00_axi_rvalid,
  s00_axi_rready,
  s00_axi_aclk,
  s00_axi_aresetn
);

(* X_INTERFACE_INFO = "xilinx.com:interface:aximm:1.0 S00_AXI AWADDR" *)
(* X_INTERFACE_MODE = "slave" *)
(* X_INTERFACE_PARAMETER = "XIL_INTERFACENAME S00_AXI, WIZ_DATA_WIDTH 32, WIZ_NUM_REG 4, SUPPORTS_NARROW_BURST 0, DATA_WIDTH 32, PROTOCOL AXI4LITE, FREQ_HZ 100000000, ID_WIDTH 0, ADDR_WIDTH 4, AWUSER_WIDTH 0, ARUSER_WIDTH 0, WUSER_WIDTH 0, RUSER_WIDTH 0, BUSER_WIDTH 0, READ_WRITE_MODE READ_WRITE, HAS_BURST 0, HAS_LOCK 0, HAS_PROT 1, HAS_CACHE 0, HAS_QOS 0, HAS_REGION 0, HAS_WSTRB 1, HAS_BRESP 1, HAS_RRESP 1, NUM_READ_OUTSTANDING 8, NUM_WRITE_OUTSTANDING 8, MAX_BURST_LENGTH 1, PHASE 0.0, CLK_DOMAIN block_design_processing_s\
ystem7_0_0_FCLK_CLK0, NUM_READ_THREADS 1, NUM_WRITE_THREADS 1, RUSER_BITS_PER_BYTE 0, WUSER_BITS_PER_BYTE 0, INSERT_VIP 0" *)
input wire [3 : 0] s00_axi_awaddr;
(* X_INTERFACE_INFO = "xilinx.com:interface:aximm:1.0 S00_AXI AWPROT" *)
input wire [2 : 0] s00_axi_awprot;
(* X_INTERFACE_INFO = "xilinx.com:interface:aximm:1.0 S00_AXI AWVALID" *)
input wire s00_axi_awvalid;
(* X_INTERFACE_INFO = "xilinx.com:interface:aximm:1.0 S00_AXI AWREADY" *)
output wire s00_axi_awready;
(* X_INTERFACE_INFO = "xilinx.com:interface:aximm:1.0 S00_AXI WDATA" *)
input wire [31 : 0] s00_axi_wdata;
(* X_INTERFACE_INFO = "xilinx.com:interface:aximm:1.0 S00_AXI WSTRB" *)
input wire [3 : 0] s00_axi_wstrb;
(* X_INTERFACE_INFO = "xilinx.com:interface:aximm:1.0 S00_AXI WVALID" *)
input wire s00_axi_wvalid;
(* X_INTERFACE_INFO = "xilinx.com:interface:aximm:1.0 S00_AXI WREADY" *)
output wire s00_axi_wready;
(* X_INTERFACE_INFO = "xilinx.com:interface:aximm:1.0 S00_AXI BRESP" *)
output wire [1 : 0] s00_axi_bresp;
(* X_INTERFACE_INFO = "xilinx.com:interface:aximm:1.0 S00_AXI BVALID" *)
output wire s00_axi_bvalid;
(* X_INTERFACE_INFO = "xilinx.com:interface:aximm:1.0 S00_AXI BREADY" *)
input wire s00_axi_bready;
(* X_INTERFACE_INFO = "xilinx.com:interface:aximm:1.0 S00_AXI ARADDR" *)
input wire [3 : 0] s00_axi_araddr;
(* X_INTERFACE_INFO = "xilinx.com:interface:aximm:1.0 S00_AXI ARPROT" *)
input wire [2 : 0] s00_axi_arprot;
(* X_INTERFACE_INFO = "xilinx.com:interface:aximm:1.0 S00_AXI ARVALID" *)
input wire s00_axi_arvalid;
(* X_INTERFACE_INFO = "xilinx.com:interface:aximm:1.0 S00_AXI ARREADY" *)
output wire s00_axi_arready;
(* X_INTERFACE_INFO = "xilinx.com:interface:aximm:1.0 S00_AXI RDATA" *)
output wire [31 : 0] s00_axi_rdata;
(* X_INTERFACE_INFO = "xilinx.com:interface:aximm:1.0 S00_AXI RRESP" *)
output wire [1 : 0] s00_axi_rresp;
(* X_INTERFACE_INFO = "xilinx.com:interface:aximm:1.0 S00_AXI RVALID" *)
output wire s00_axi_rvalid;
(* X_INTERFACE_INFO = "xilinx.com:interface:aximm:1.0 S00_AXI RREADY" *)
input wire s00_axi_rready;
(* X_INTERFACE_INFO = "xilinx.com:signal:clock:1.0 S00_AXI_CLK CLK" *)
(* X_INTERFACE_MODE = "slave" *)
(* X_INTERFACE_PARAMETER = "XIL_INTERFACENAME S00_AXI_CLK, ASSOCIATED_BUSIF S00_AXI, ASSOCIATED_RESET s00_axi_aresetn, FREQ_HZ 100000000, FREQ_TOLERANCE_HZ 0, PHASE 0.0, CLK_DOMAIN block_design_processing_system7_0_0_FCLK_CLK0, INSERT_VIP 0" *)
input wire s00_axi_aclk;
(* X_INTERFACE_INFO = "xilinx.com:signal:reset:1.0 S00_AXI_RST RST" *)
(* X_INTERFACE_MODE = "slave" *)
(* X_INTERFACE_PARAMETER = "XIL_INTERFACENAME S00_AXI_RST, POLARITY ACTIVE_LOW, INSERT_VIP 0" *)
input wire s00_axi_aresetn;

  fft_ip #(
    .C_S00_AXI_DATA_WIDTH(32),  // Width of S_AXI data bus
    .C_S00_AXI_ADDR_WIDTH(4)  // Width of S_AXI address bus
  ) inst (
    .s00_axi_awaddr(s00_axi_awaddr),
    .s00_axi_awprot(s00_axi_awprot),
    .s00_axi_awvalid(s00_axi_awvalid),
    .s00_axi_awready(s00_axi_awready),
    .s00_axi_wdata(s00_axi_wdata),
    .s00_axi_wstrb(s00_axi_wstrb),
    .s00_axi_wvalid(s00_axi_wvalid),
    .s00_axi_wready(s00_axi_wready),
    .s00_axi_bresp(s00_axi_bresp),
    .s00_axi_bvalid(s00_axi_bvalid),
    .s00_axi_bready(s00_axi_bready),
    .s00_axi_araddr(s00_axi_araddr),
    .s00_axi_arprot(s00_axi_arprot),
    .s00_axi_arvalid(s00_axi_arvalid),
    .s00_axi_arready(s00_axi_arready),
    .s00_axi_rdata(s00_axi_rdata),
    .s00_axi_rresp(s00_axi_rresp),
    .s00_axi_rvalid(s00_axi_rvalid),
    .s00_axi_rready(s00_axi_rready),
    .s00_axi_aclk(s00_axi_aclk),
    .s00_axi_aresetn(s00_axi_aresetn)
  );
endmodule
