JonahZil/fpga-radar-projects/BGT-FMCW-pipeline/ps-pl-hdl/fmcw-output-slave.v

`timescale 1 ns / 1 ps

	module fmcw_output_slave #
	(

		// Parameters of Axi Slave Bus Interface S00_AXI
		parameter integer C_S00_AXI_DATA_WIDTH	= 32,
		parameter integer C_S00_AXI_ADDR_WIDTH	= 5
	)
	(

		// Ports of Axi Slave Bus Interface S00_AXI
		input wire  s00_axi_aclk,
		input wire  s00_axi_aresetn,
		input wire [C_S00_AXI_ADDR_WIDTH-1 : 0] s00_axi_awaddr,
		input wire [2 : 0] s00_axi_awprot,
		input wire  s00_axi_awvalid,
		output wire  s00_axi_awready,
		input wire [C_S00_AXI_DATA_WIDTH-1 : 0] s00_axi_wdata,
		input wire [(C_S00_AXI_DATA_WIDTH/8)-1 : 0] s00_axi_wstrb,
		input wire  s00_axi_wvalid,
		output wire  s00_axi_wready,
		output wire [1 : 0] s00_axi_bresp,
		output wire  s00_axi_bvalid,
		input wire  s00_axi_bready,
		input wire [C_S00_AXI_ADDR_WIDTH-1 : 0] s00_axi_araddr,
		input wire [2 : 0] s00_axi_arprot,
		input wire  s00_axi_arvalid,
		output wire  s00_axi_arready,
		output wire [C_S00_AXI_DATA_WIDTH-1 : 0] s00_axi_rdata,
		output wire [1 : 0] s00_axi_rresp,
		output wire  s00_axi_rvalid,
		input wire  s00_axi_rready,
		
		//SPI lines
		input wire start,
		input wire MISO,
		input wire IRQ,
		output wire SCLK,
		output wire MOSI,
		output wire SRST,
		output wire CS_N
	);
	
	wire buf_out_ready;
	
    wire signed [17:0] alpha;
    wire signed [17:0] beta;
    wire [23:0] range_calc;
    wire buf_out_valid;
	
// Instantiation of Axi Bus Interface S00_AXI
	fmcw_output_slave_slave_lite_v1_0_S00_AXI # ( 
		.C_S_AXI_DATA_WIDTH(C_S00_AXI_DATA_WIDTH),
		.C_S_AXI_ADDR_WIDTH(C_S00_AXI_ADDR_WIDTH)
	) fmcw_output_slave_slave_lite_v1_0_S00_AXI_inst (
        .buf_out_ready    (buf_out_ready),
    
        .alpha(alpha),
        .beta(beta),
        .range_calc(range_calc),
        .buf_out_valid(buf_out_valid),
		.S_AXI_ACLK(s00_axi_aclk),
		.S_AXI_ARESETN(s00_axi_aresetn),
		.S_AXI_AWADDR(s00_axi_awaddr),
		.S_AXI_AWPROT(s00_axi_awprot),
		.S_AXI_AWVALID(s00_axi_awvalid),
		.S_AXI_AWREADY(s00_axi_awready),
		.S_AXI_WDATA(s00_axi_wdata),
		.S_AXI_WSTRB(s00_axi_wstrb),
		.S_AXI_WVALID(s00_axi_wvalid),
		.S_AXI_WREADY(s00_axi_wready),
		.S_AXI_BRESP(s00_axi_bresp),
		.S_AXI_BVALID(s00_axi_bvalid),
		.S_AXI_BREADY(s00_axi_bready),
		.S_AXI_ARADDR(s00_axi_araddr),
		.S_AXI_ARPROT(s00_axi_arprot),
		.S_AXI_ARVALID(s00_axi_arvalid),
		.S_AXI_ARREADY(s00_axi_arready),
		.S_AXI_RDATA(s00_axi_rdata),
		.S_AXI_RRESP(s00_axi_rresp),
		.S_AXI_RVALID(s00_axi_rvalid),
		.S_AXI_RREADY(s00_axi_rready)
	);
    
    //Instantiation of buffer
    top_io_buffer # (
        .N(256),
        .RANGE_PARAMETER(16'd37500),
        .FIRST_BIN(6),
        .LAST_BIN(52),
        .FRAME_DELAY(1666667) //60 FPS
    ) buffer (
        .clk(s00_axi_aclk),
        .rst(~s00_axi_aresetn),
        .start(start),
        
        .MISO(MISO),
        .IRQ(IRQ),
        
        .SCLK(SCLK),
        .MOSI(MOSI),
        .SRST(SRST),
        .CS_N(CS_N),
        
        .out_ready(buf_out_ready),
    
        .alpha(alpha),
        .beta(beta),
        .range_calc(range_calc),
        .out_valid(buf_out_valid)
	);

	endmodule
