JonahZil/fpga-radar-projects/BGT-FMCW-pipeline/sources/DSP/asin_rom.v

module asin_rom #(
    parameter FILE = "",
    parameter DEPTH = 805
)(
    input clk,
   
    input [9:0] address,
    
    output wire [17:0] rom_out
);

    xpm_memory_sprom #(
        .ADDR_WIDTH_A        (10),
        .AUTO_SLEEP_TIME     (0),
        .CASCADE_HEIGHT      (0),
        .ECC_MODE            ("no_ecc"),
        .MEMORY_INIT_FILE    (FILE),
        .MEMORY_INIT_PARAM   (""),
        .MEMORY_OPTIMIZATION ("true"),
        .MEMORY_PRIMITIVE    ("block"),
        .MEMORY_SIZE         (18*DEPTH),
        .MESSAGE_CONTROL     (0),
        .READ_DATA_WIDTH_A   (18),
        .READ_LATENCY_A      (1),
        .READ_RESET_VALUE_A  ("0"),
        .RST_MODE_A          ("SYNC"),
        .SIM_ASSERT_CHK      (0),
        .USE_MEM_INIT        (1),
        .WAKEUP_TIME         ("disable_sleep")
    ) tw_rom (
        .clka   (clk),
        .rsta   (1'b0),
        .ena    (1'b1),
        .regcea (1'b1),
        .addra  (address),
        .douta  (rom_out),
        .dbiterra(),
        .sbiterra(),
        .injectdbiterra(1'b0),
        .injectsbiterra(1'b0),
        .sleep  (1'b0)
    );

endmodule
