JonahZil/fpga-radar-projects/(commit log)

2026-03-04 Added stage module, have not implemented timings or logic yet
2026-03-05 Added logic for stage_module, no twiddle yet
2026-03-10 Fixed timing issue with butterfly module
    [butterfly_module.v, delay_line.v, stage_module.v, testbench.v]
2026-03-24 Fixed allignment issues in stage module, now works. Missing twiddle factors
    [delay_line.v, stage_module.v, testbench.v]
2026-04-01 Added the 32 point FFT FPGA pipeline, though bugs appear in the delay line.
    [butterfly-module.v, constraints.xdc, delay-line.v, sdf-fft.v, stage-module.v, test_bench.v, twiddle-rom.v]
2026-04-03 Made the delay line synchronous, has not fixed issues yet
    [delay-line.v, sdf-fft.v, stage-module.v, test_bench.v]
2026-05-07 Final public commit of files
    [fpga_input_samples.csv]
2026-05-07 Added detailed README file and the simulated FMCW radar model
    [fpga_input_samples.csv]
2026-06-25 Added files for BGT pipeline
    [Adapter-PCB.kicad_pcb]
2026-07-31 Implemented a simple testbench for one simulated frame. Added header comments for each python file.
2026-07-31 Added photo of adapter board to README file
